IMMRMKW/KICAD/README.md

This repository contains some of the schematic part and housing libraries I created or found online in other repositories. I have put them online so that it will be easier for KICAD users to finish projects in which these parts happen to be integrated. Take care though, although most parts I really tried them out, there may still be some errors in them.

- [ ] some task
