IMMRMKW/KICAD/ugl-kicad-lib-master/README.md

# ugl-kicad-lib



Contains a KiCad library with many of the footprints required to create the Ultimate Hacking Keyboard.

[UHK github](https://github.com/UltimateHackingKeyboard)

[CrowdSupply](https://www.crowdsupply.com/ugl/ultimate-hacking-keyboard)

## Usage

**Open Eschema Editor**


**Preferences --> Component Libraries**



**Add a relative or absolute path to "User defined search path"**
