IMMRMKW/KICAD/random.png

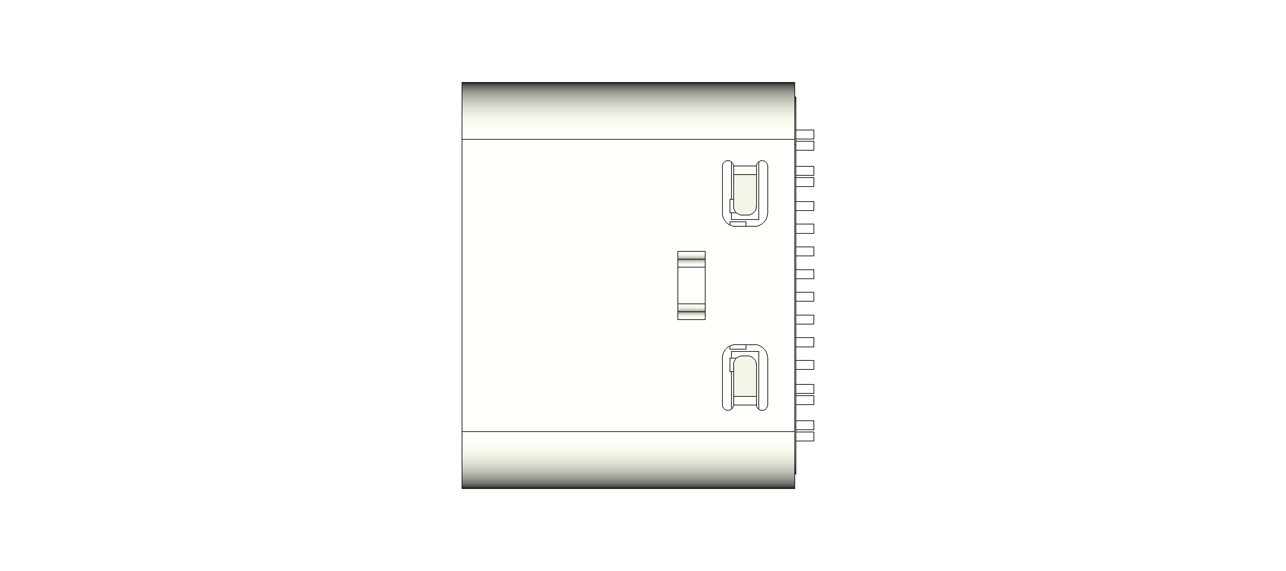
random.png
