IMMRMKW/KICAD/DC Power Jack 5.5mm x 2.1mm.STEP

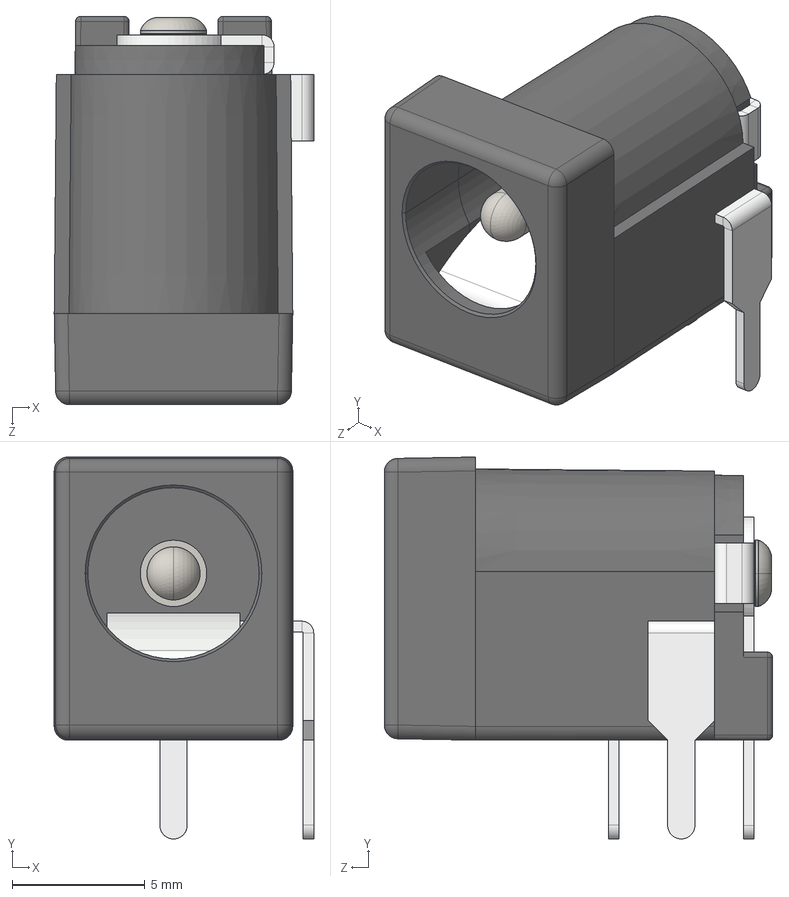
[picture p2: CAD file, 2023-07-05]
DC Power Jack 5.5mm x 2.1mm.STEP
9.77 x 14.4 x 14.6 mm
