IMMRMKW/KICAD/JST_SH/BMxxB-SRSR-TB/BM15B-SRSS-TB.STEP

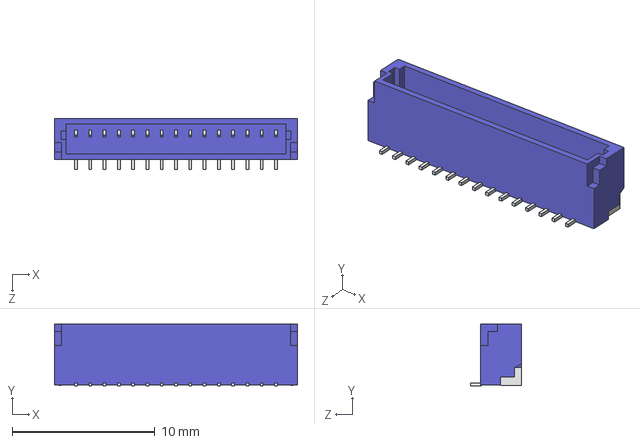
[picture p3: CAD file, 2023-07-05]
JST_SH/BMxxB-SRSR-TB/BM15B-SRSS-TB.STEP
17.0 x 4.32 x 3.60 mm
