IMMRMKW/KICAD/JST_SH/SHR-xxV-S-B/SHR-07V-S-B.STEP

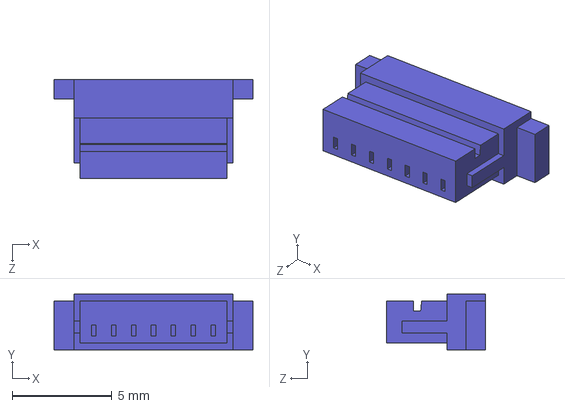
[picture p4: CAD file, 2023-07-05]
JST_SH/SHR-xxV-S-B/SHR-07V-S-B.STEP
10.0 x 2.80 x 5.00 mm
