IMMRMKW/KICAD/JST_SH/SHR-xxV-S/SHR-09V-S.STEP

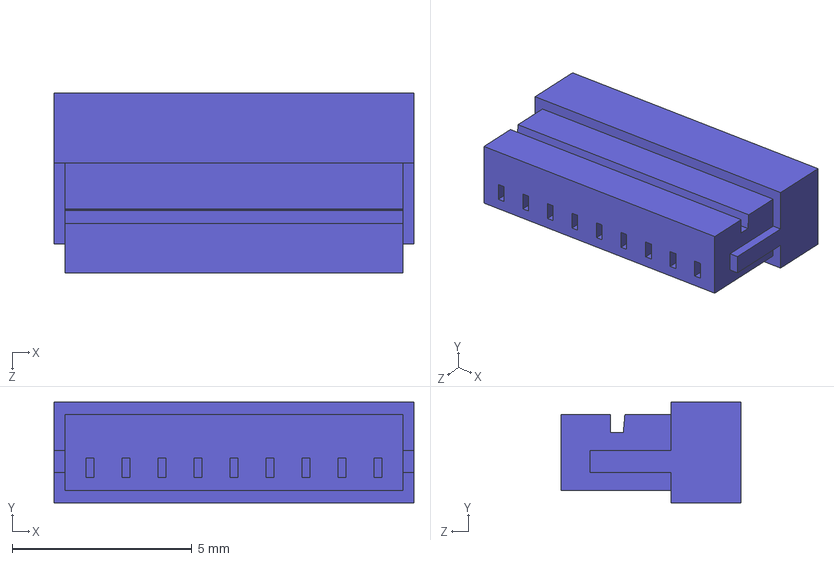
[picture p5: CAD file, 2023-07-05]
JST_SH/SHR-xxV-S/SHR-09V-S.STEP
10.0 x 2.80 x 5.00 mm
