IMMRMKW/KICAD/JST_SH/SMxxB-SRSS-TB/SM08B-SRSS-TB.STEP

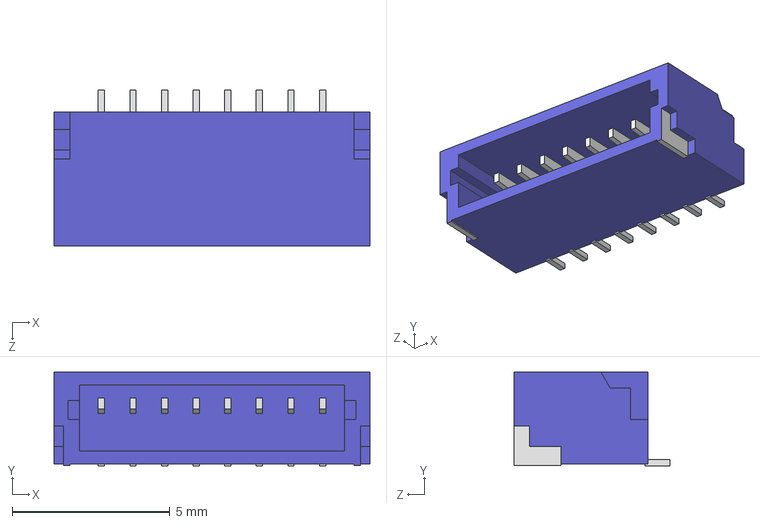
[picture p6: CAD file, 2023-07-05]
JST_SH/SMxxB-SRSS-TB/SM08B-SRSS-TB.STEP
10.0 x 2.96 x 4.95 mm
