IMMRMKW/KICAD/JST_SH/SSH-003T-P0.2-H/SSH-003T-P0.2-H.STEP

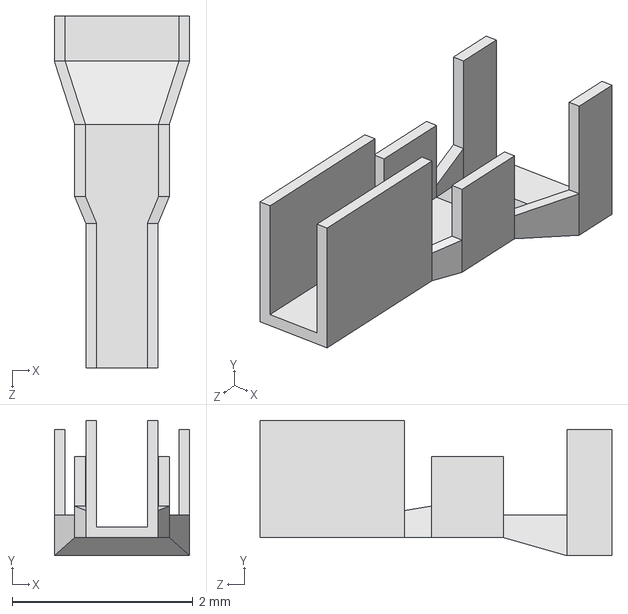
[picture p7: CAD file, 2023-07-05]
JST_SH/SSH-003T-P0.2-H/SSH-003T-P0.2-H.STEP
1.50 x 1.50 x 3.90 mm
