IMMRMKW/KICAD/HRO_TYPE-C-31-M-12.step

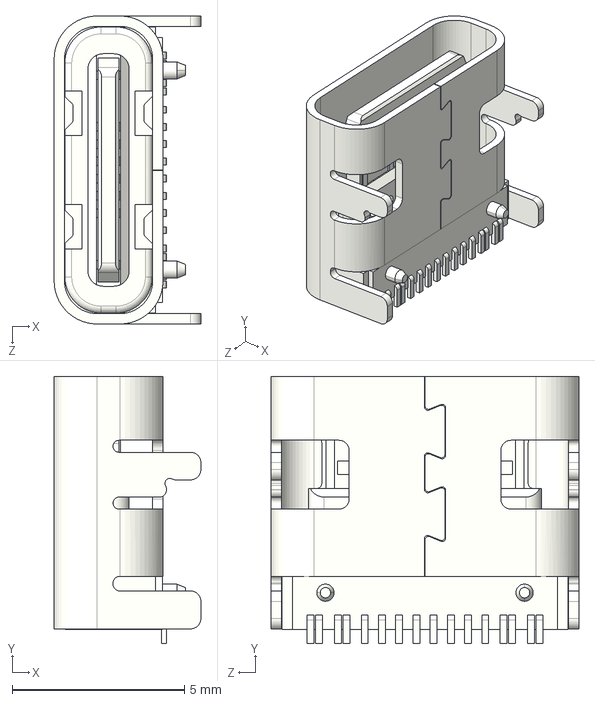
[picture p8: CAD file, 2023-07-05]
HRO_TYPE-C-31-M-12.step
4.26 x 7.75 x 8.94 mm
