IMMRMKW/KICAD/JST_SH/SHR-xxV-S-B/SHR-11V-S-B.STEP

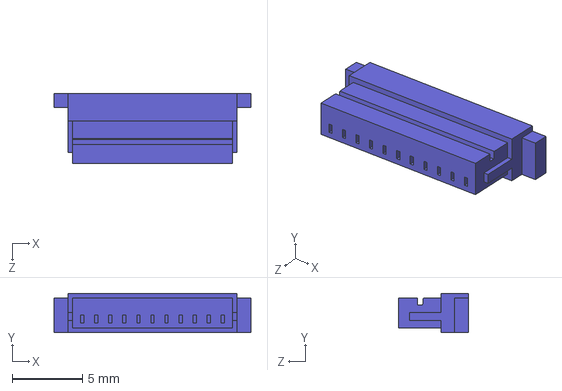
[picture p10: CAD file, 2023-07-05]
JST_SH/SHR-xxV-S-B/SHR-11V-S-B.STEP
14.0 x 2.80 x 5.00 mm
