IMMRMKW/KICAD/JST_SH/SHR-xxV-S/SHR-15V-S.STEP

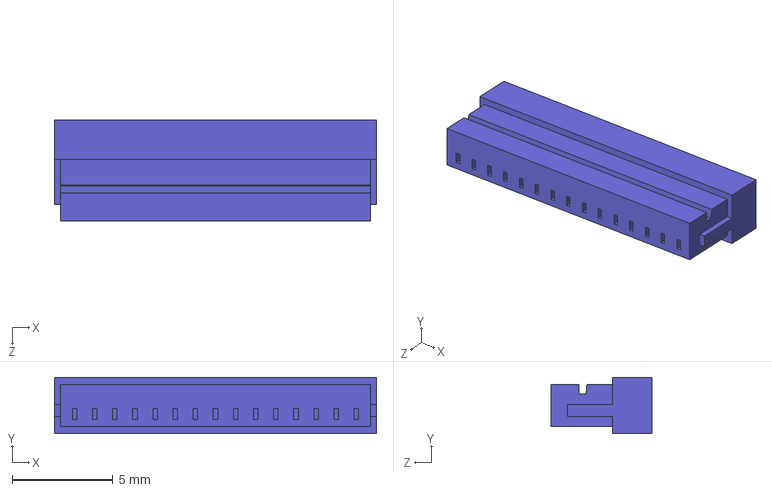
[picture p11: CAD file, 2023-07-05]
JST_SH/SHR-xxV-S/SHR-15V-S.STEP
16.0 x 2.80 x 5.00 mm
