IMMRMKW/KICAD/JST_SH/SMxxB-SRSS-TB/SM12B-SRSS-TB.STEP

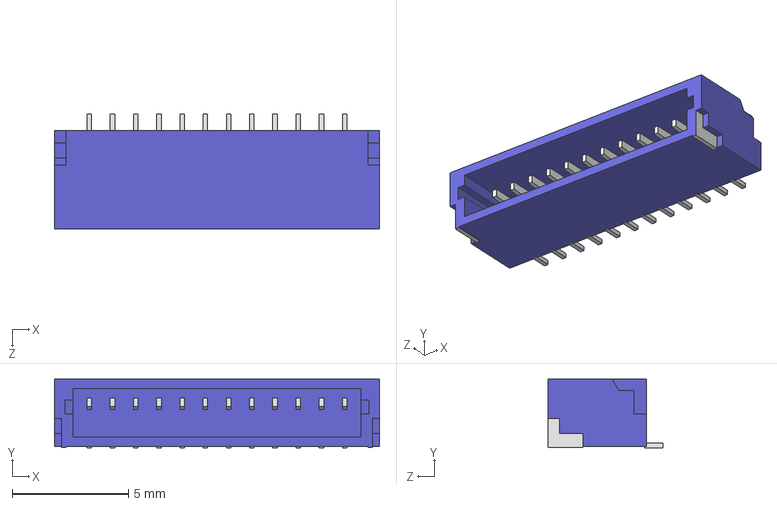
[picture p12: CAD file, 2023-07-05]
JST_SH/SMxxB-SRSS-TB/SM12B-SRSS-TB.STEP
14.0 x 2.96 x 4.95 mm
