IMMRMKW/KICAD/JST_SH/BMxxB-SRSR-TB/BM09B-SRSS-TB.STEP

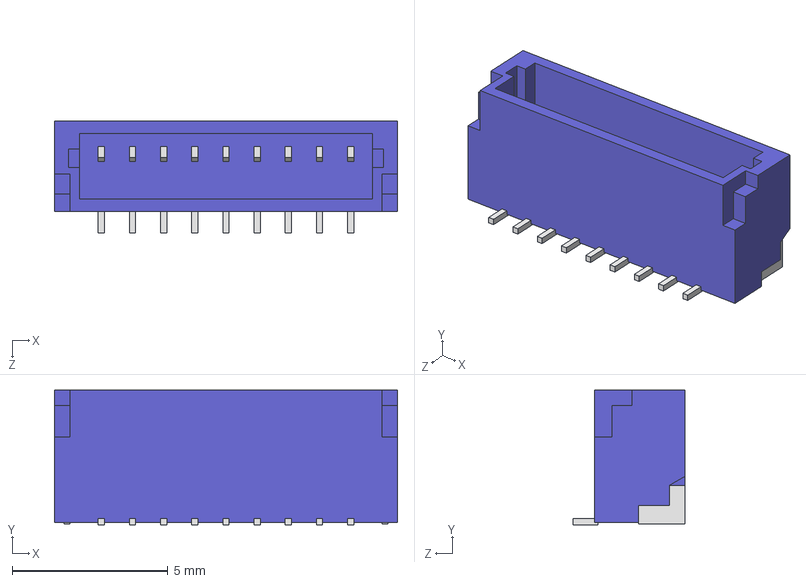
[picture p13: CAD file, 2023-07-05]
JST_SH/BMxxB-SRSR-TB/BM09B-SRSS-TB.STEP
11.0 x 4.32 x 3.60 mm
