IMMRMKW/KICAD/JST_SH/SHR-xxV-S-B/SHR-04V-S-B.STEP

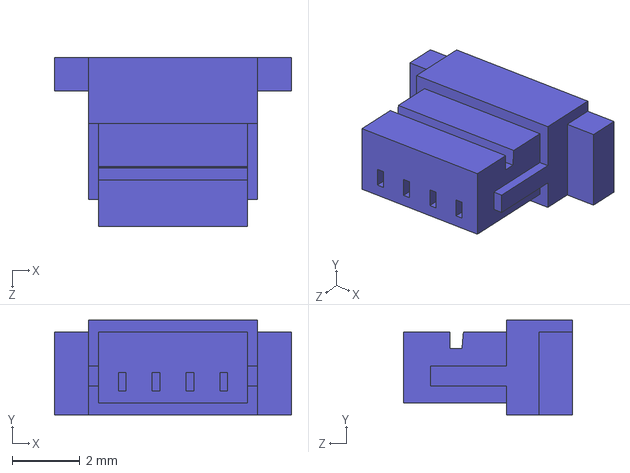
[picture p14: CAD file, 2023-07-05]
JST_SH/SHR-xxV-S-B/SHR-04V-S-B.STEP
7.00 x 2.80 x 5.00 mm
