IMMRMKW/KICAD/JST_SH/SHR-xxV-S/SHR-08V-S.STEP

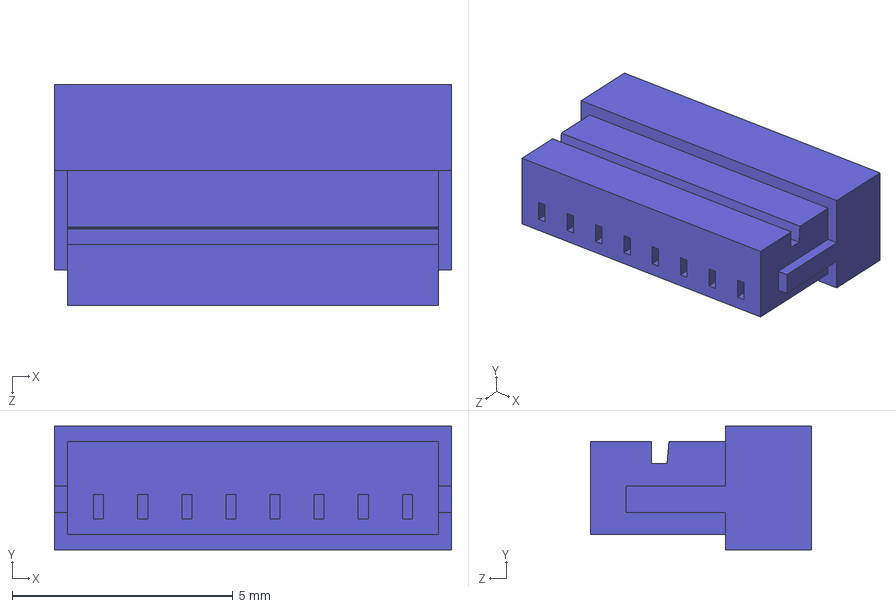
[picture p15: CAD file, 2023-07-05]
JST_SH/SHR-xxV-S/SHR-08V-S.STEP
9.00 x 2.80 x 5.00 mm
