IMMRMKW/KICAD/JST_SH/SMxxB-SRSS-TB/SM03B-SRSS-TB.STEP

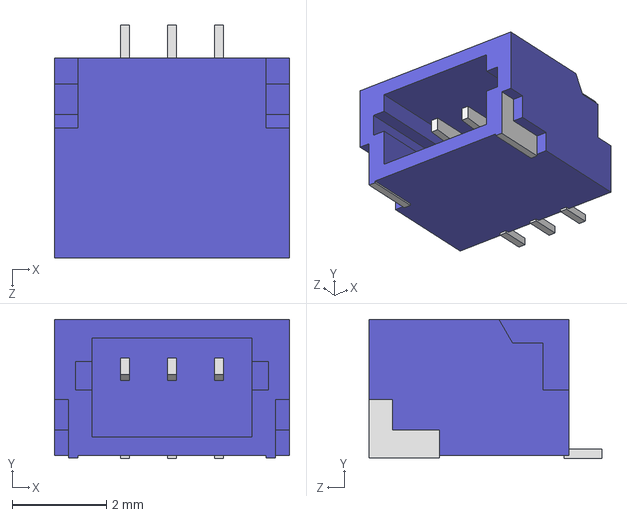
[picture p16: CAD file, 2023-07-05]
JST_SH/SMxxB-SRSS-TB/SM03B-SRSS-TB.STEP
5.00 x 2.96 x 4.95 mm
