IMMRMKW/KICAD/TSSOP-10.step

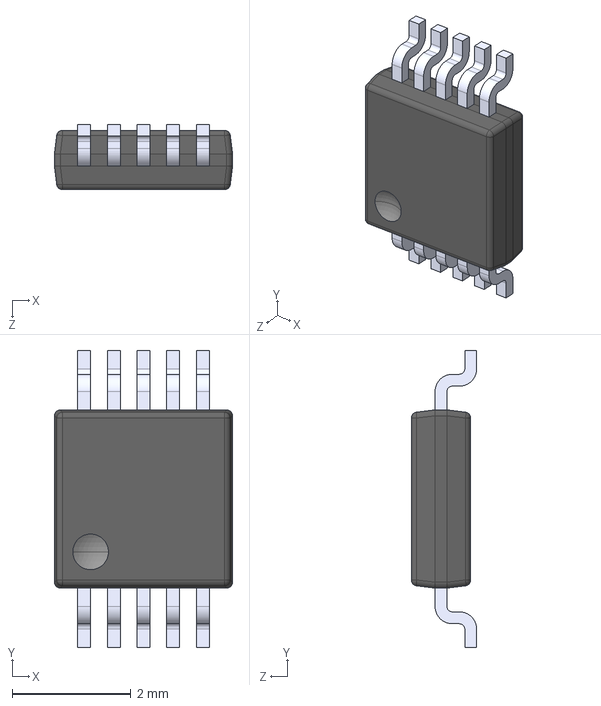
[picture p17: CAD file, 2023-07-05]
TSSOP-10.step
3.00 x 5.00 x 1.10 mm
