IMMRMKW/KICAD/JST_SH/SHR-xxV-S/SHR-07V-S.STEP

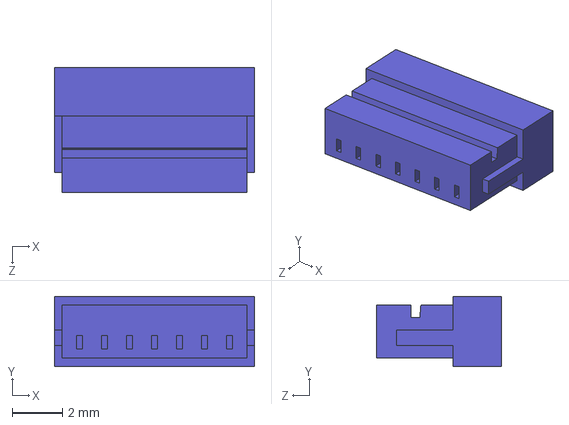
[picture p20: CAD file, 2023-07-05]
JST_SH/SHR-xxV-S/SHR-07V-S.STEP
8.00 x 2.80 x 5.00 mm
