IMMRMKW/KICAD/NFE61P series.STEP

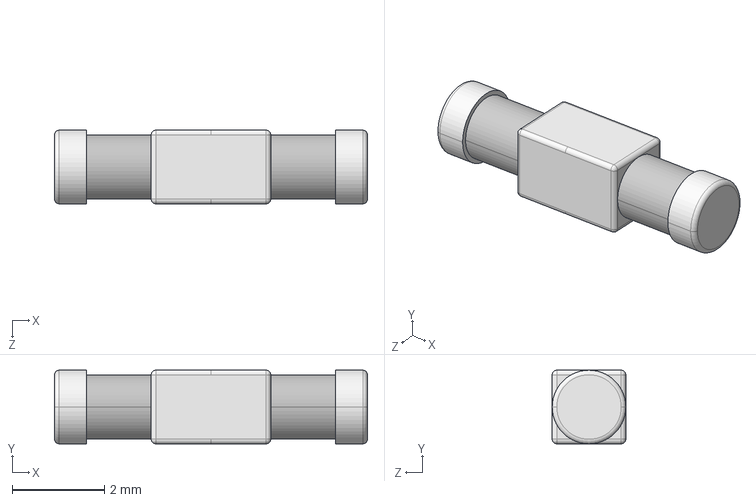
[picture p22: CAD file, 2023-07-05]
NFE61P series.STEP
6.80 x 1.60 x 1.60 mm
