IMMRMKW/KICAD/DC-005.step

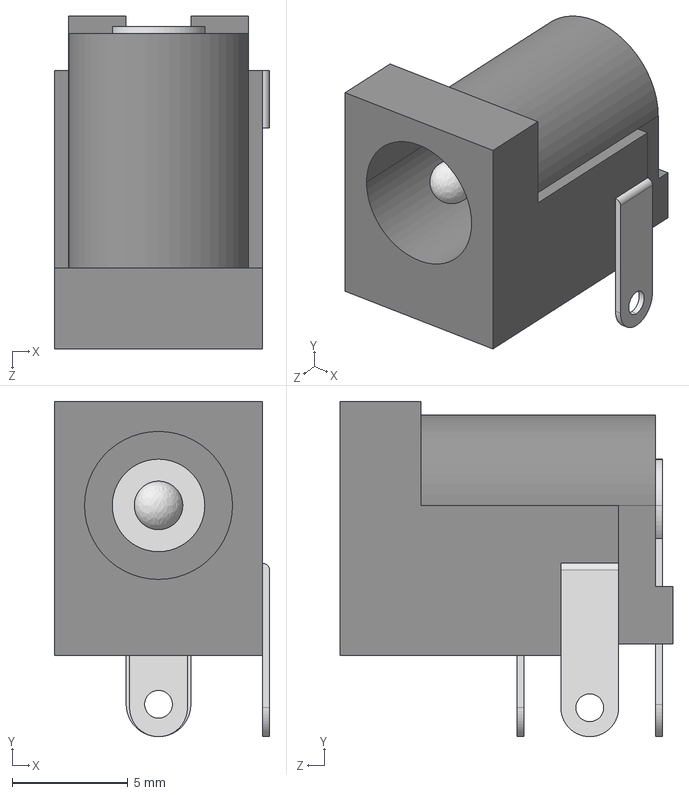
[picture p23: CAD file, 2023-07-05]
DC-005.step
9.30 x 14.5 x 14.4 mm
