IMMRMKW/KICAD/JST_SH/BMxxB-SRSR-TB/BM07B-SRSS-TB.STEP

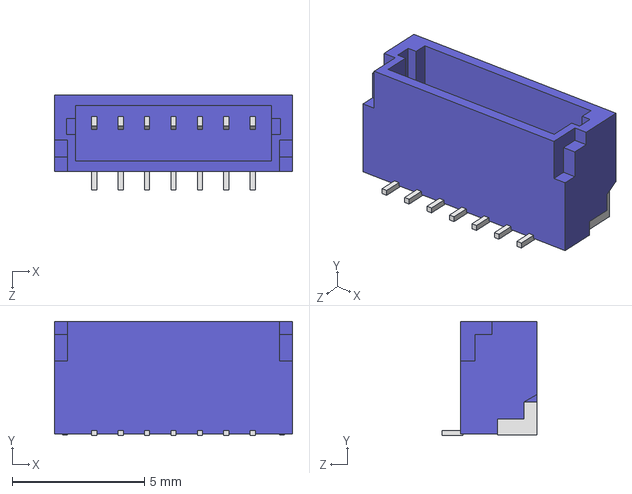
[picture p24: CAD file, 2023-07-05]
JST_SH/BMxxB-SRSR-TB/BM07B-SRSS-TB.STEP
9.00 x 4.32 x 3.60 mm
