IMMRMKW/KICAD/JST_SH/SHR-xxV-S-B/SHR-05V-S-B.STEP

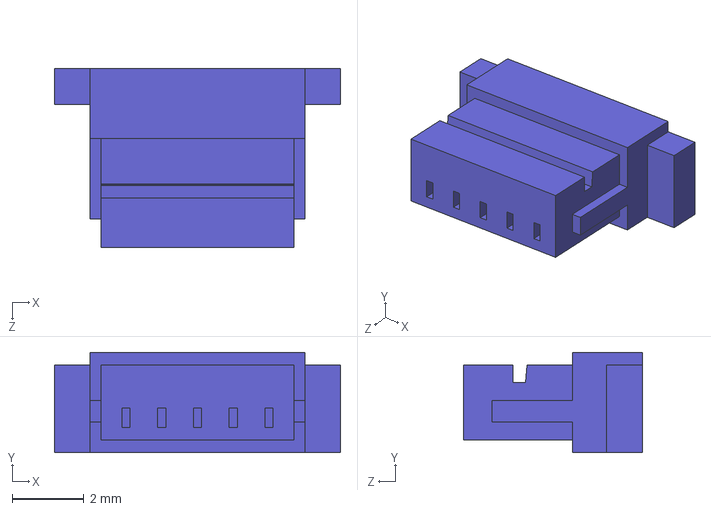
[picture p25: CAD file, 2023-07-05]
JST_SH/SHR-xxV-S-B/SHR-05V-S-B.STEP
8.00 x 2.80 x 5.00 mm
