IMMRMKW/KICAD/JST_SH/SHR-xxV-S/SHR-03V-S.STEP

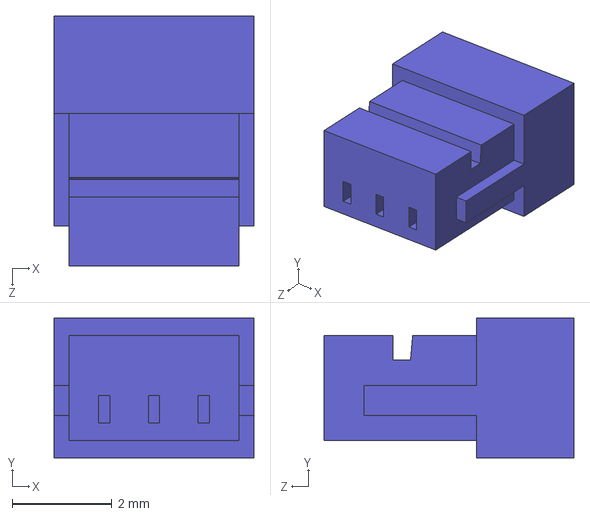
[picture p26: CAD file, 2023-07-05]
JST_SH/SHR-xxV-S/SHR-03V-S.STEP
4.00 x 2.80 x 5.00 mm
