IMMRMKW/KICAD/JST_SH/BMxxB-SRSR-TB/BM11B-SRSS-TB.STEP

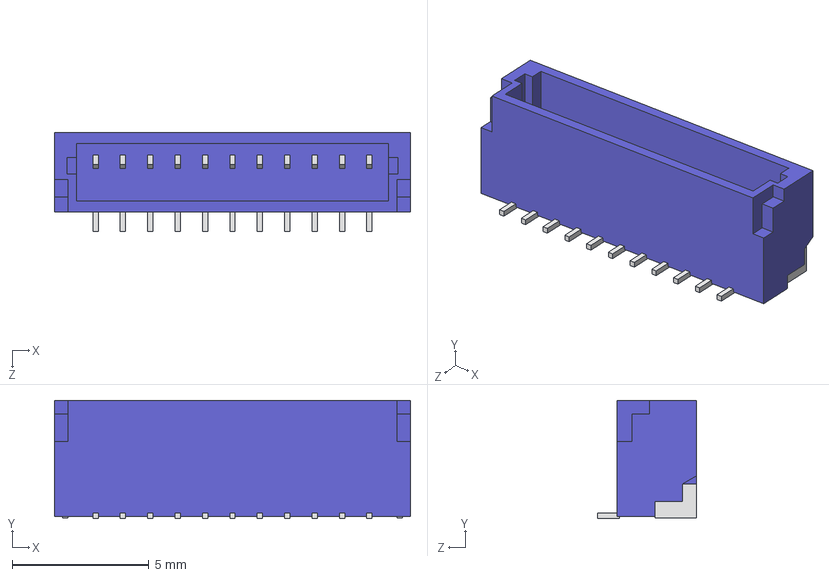
[picture p28: CAD file, 2023-07-05]
JST_SH/BMxxB-SRSR-TB/BM11B-SRSS-TB.STEP
13.0 x 4.32 x 3.60 mm
