IMMRMKW/KICAD/JST_SH/SHR-xxV-S/SHR-05V-S.STEP

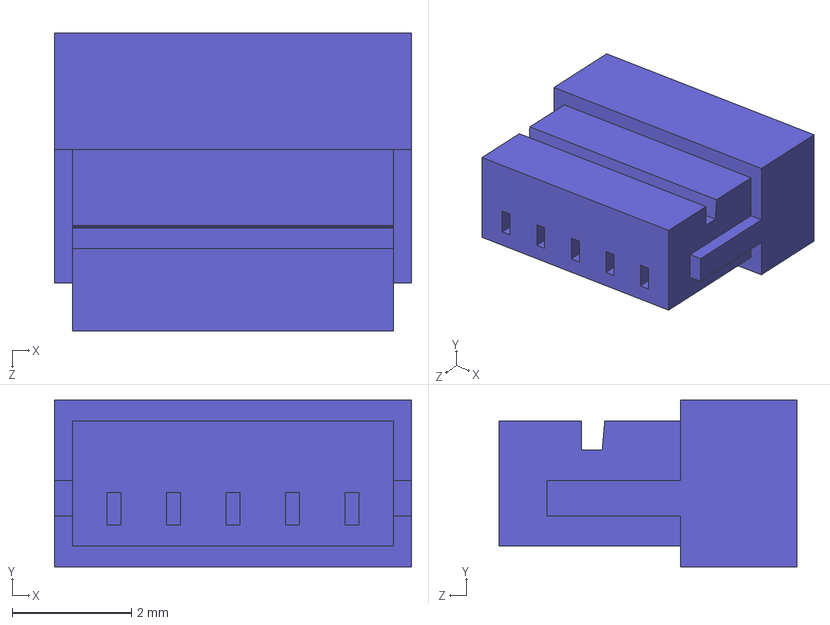
[picture p30: CAD file, 2023-07-05]
JST_SH/SHR-xxV-S/SHR-05V-S.STEP
6.00 x 2.80 x 5.00 mm
