IMMRMKW/KICAD/JST_SH/SMxxB-SRSS-TB/SM04B-SRSS-TB.STEP

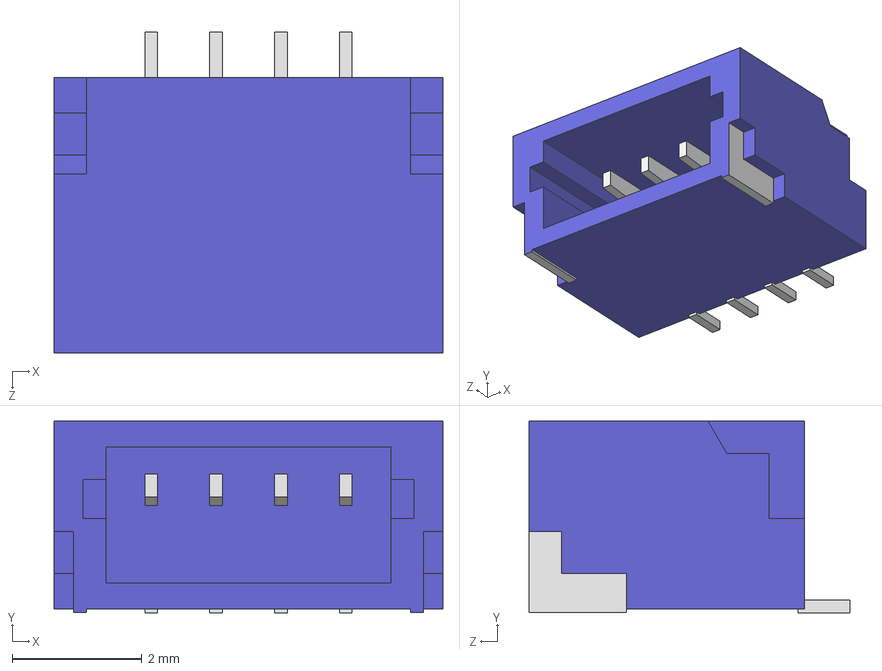
[picture p31: CAD file, 2023-07-05]
JST_SH/SMxxB-SRSS-TB/SM04B-SRSS-TB.STEP
6.00 x 2.96 x 4.95 mm
