IMMRMKW/KICAD/Yuandi TS-1092S-B3D2-G.STEP

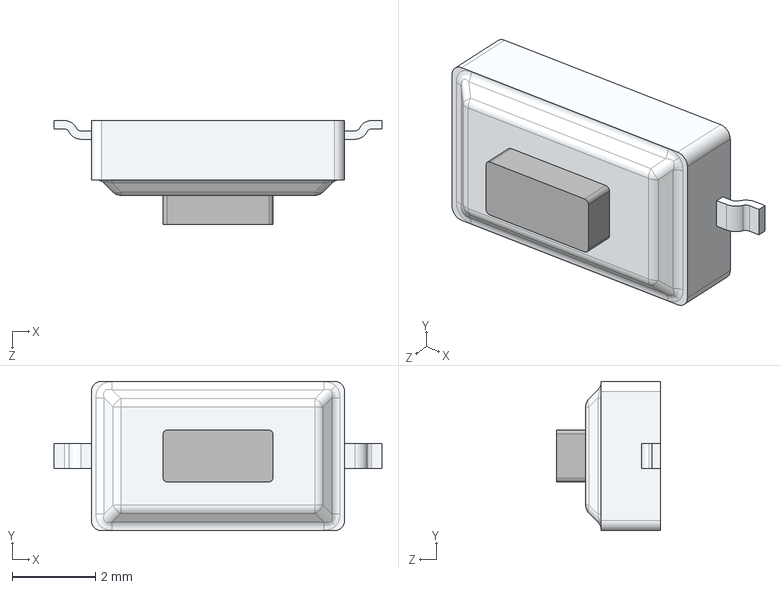
[picture p32: CAD file, 2023-07-05]
Yuandi TS-1092S-B3D2-G.STEP
7.90 x 3.60 x 2.50 mm
