IMMRMKW/KICAD/JST_SH/BMxxB-SRSR-TB/BM04B-SRSS-TB.STEP

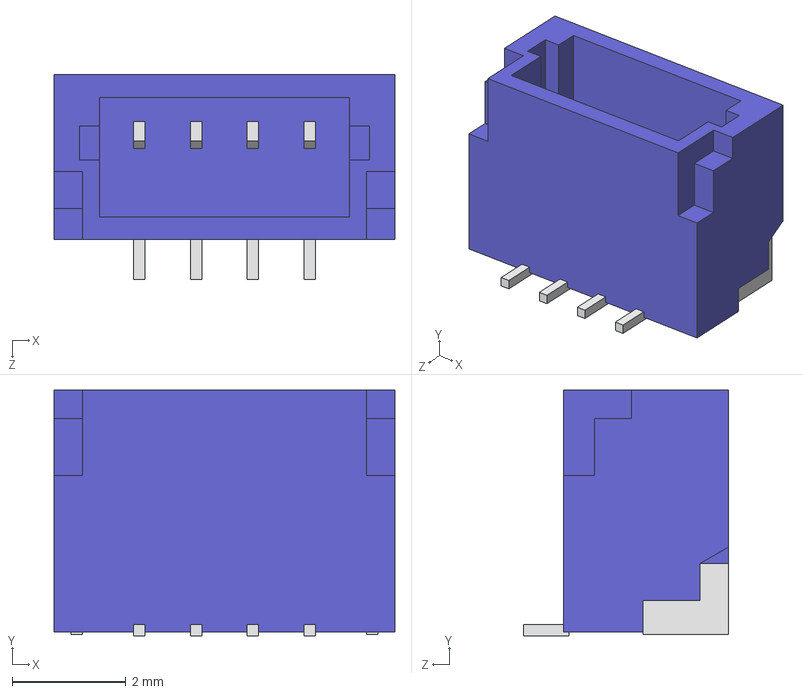
[picture p33: CAD file, 2023-07-05]
JST_SH/BMxxB-SRSR-TB/BM04B-SRSS-TB.STEP
6.00 x 4.32 x 3.60 mm
