IMMRMKW/KICAD/JST_SH/SHR-xxV-S/SHR-02V-S.STEP

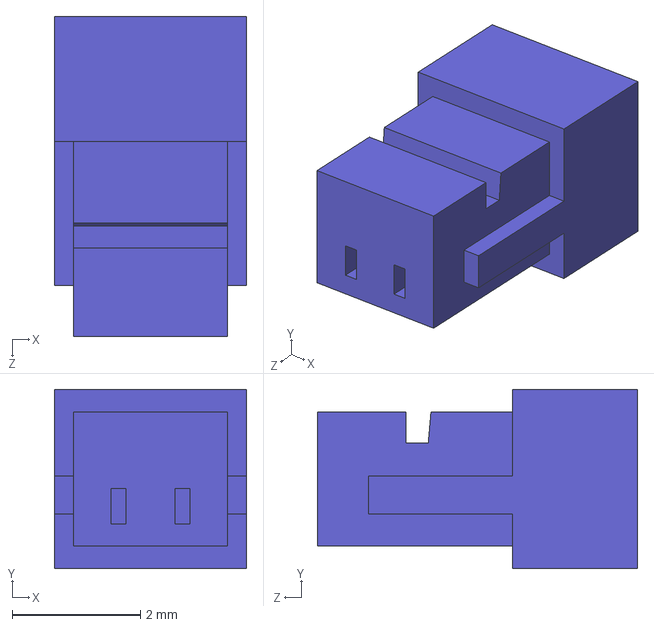
[picture p35: CAD file, 2023-07-05]
JST_SH/SHR-xxV-S/SHR-02V-S.STEP
3.00 x 2.80 x 5.00 mm
