IMMRMKW/KICAD/JST_SH/SMxxB-SRSS-TB/SM13B-SRSS-TB.STEP

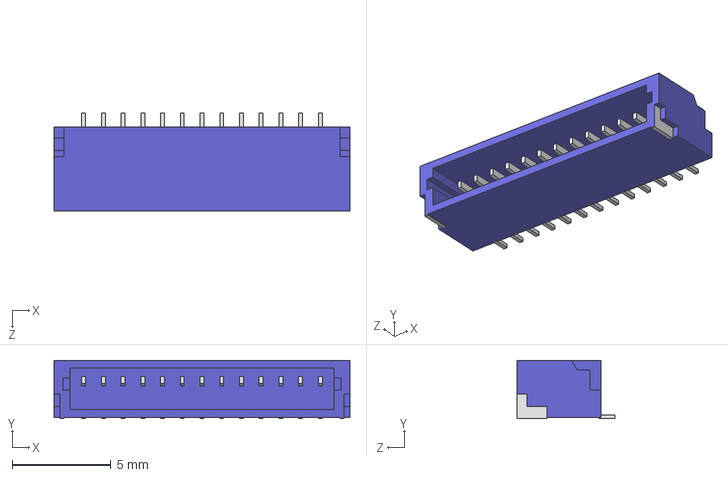
[picture p36: CAD file, 2023-07-05]
JST_SH/SMxxB-SRSS-TB/SM13B-SRSS-TB.STEP
15.0 x 2.96 x 4.95 mm
