IMMRMKW/KICAD/Fuse 2920.step

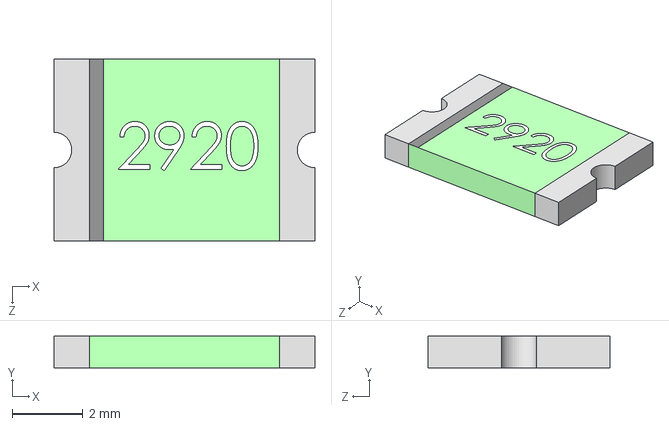
[picture p37: CAD file, 2023-07-05]
Fuse 2920.step
7.36 x 0.901 x 5.12 mm
