IMMRMKW/KICAD/JST_SH/BMxxB-SRSR-TB/BM14B-SRSS-TB.STEP

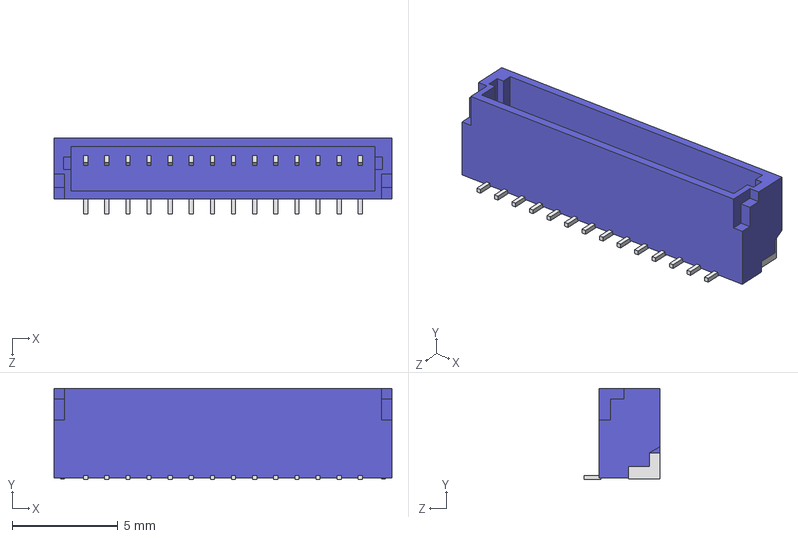
[picture p38: CAD file, 2023-07-05]
JST_SH/BMxxB-SRSR-TB/BM14B-SRSS-TB.STEP
16.0 x 4.32 x 3.60 mm
