IMMRMKW/KICAD/JST_SH/SHR-xxV-S/SHR-12V-S.STEP

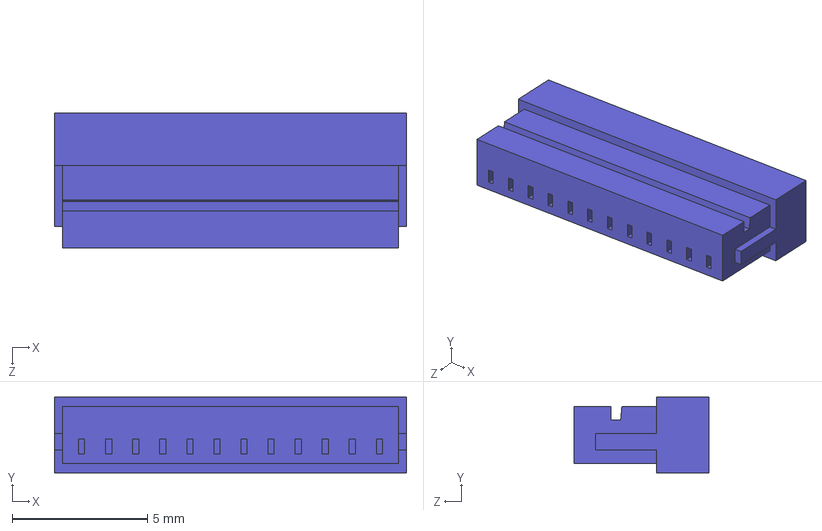
[picture p40: CAD file, 2023-07-05]
JST_SH/SHR-xxV-S/SHR-12V-S.STEP
13.0 x 2.80 x 5.00 mm
