IMMRMKW/KICAD/JST_SH/SMxxB-SRSS-TB/SM10B-SRSS-TB.STEP

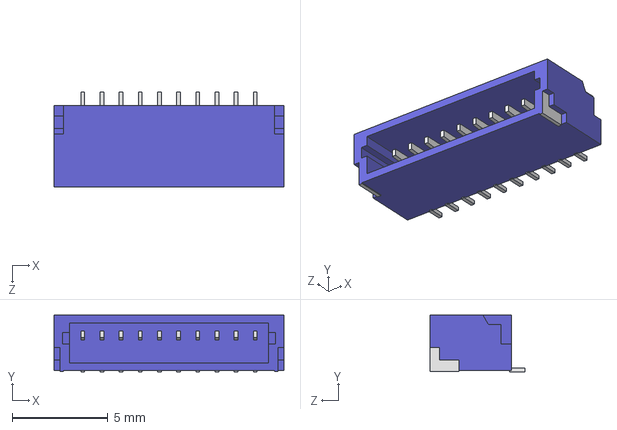
[picture p41: CAD file, 2023-07-05]
JST_SH/SMxxB-SRSS-TB/SM10B-SRSS-TB.STEP
12.0 x 2.96 x 4.95 mm
