IMMRMKW/KICAD/JST_SH/BMxxB-SRSR-TB/BM10B-SRSS-TB.STEP

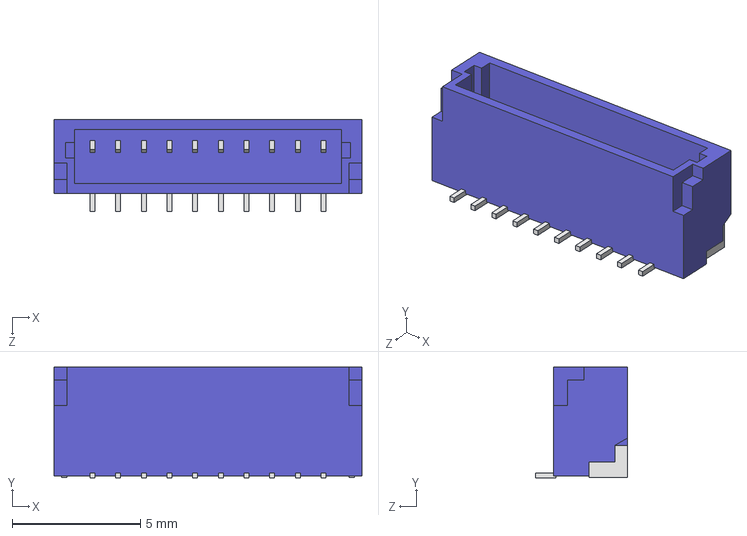
[picture p42: CAD file, 2023-07-05]
JST_SH/BMxxB-SRSR-TB/BM10B-SRSS-TB.STEP
12.0 x 4.32 x 3.60 mm
