IMMRMKW/KICAD/JST_SH/SHR-xxV-S-B/SHR-02V-S-B.STEP

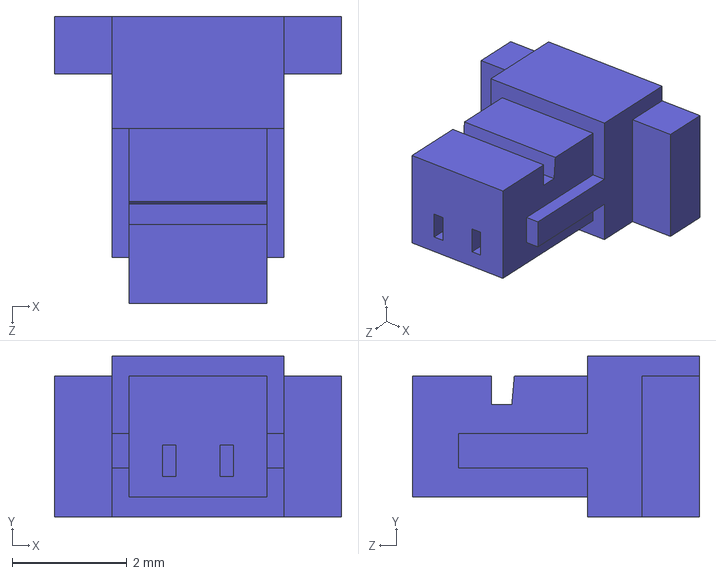
[picture p43: CAD file, 2023-07-05]
JST_SH/SHR-xxV-S-B/SHR-02V-S-B.STEP
5.00 x 2.80 x 5.00 mm
