IMMRMKW/KICAD/JST_SH/SHR-xxV-S/SHR-06V-S.STEP

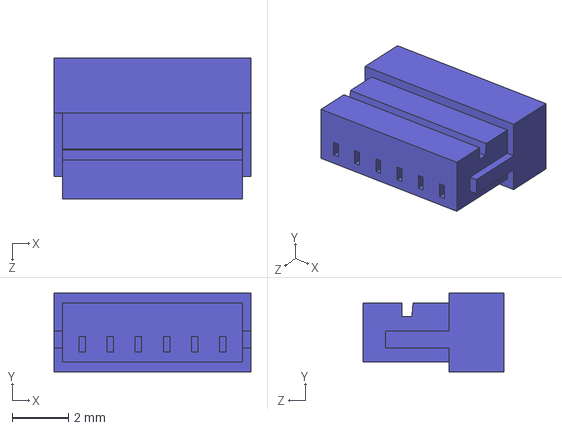
[picture p44: CAD file, 2023-07-05]
JST_SH/SHR-xxV-S/SHR-06V-S.STEP
7.00 x 2.80 x 5.00 mm
