IMMRMKW/KICAD/SMMS0850.STEP

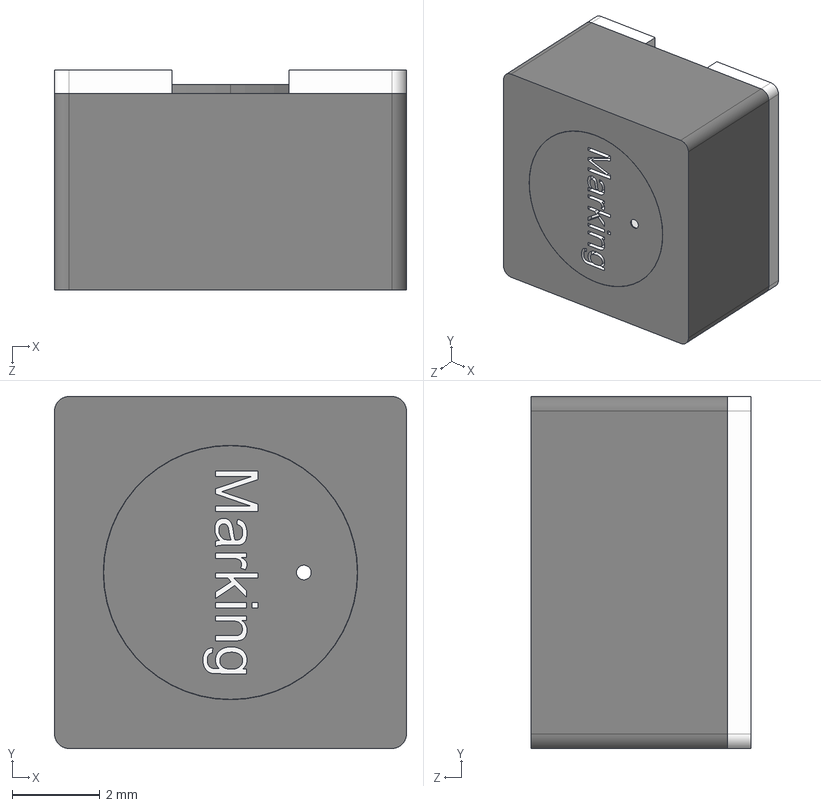
[picture p46: CAD file, 2023-07-05]
SMMS0850.STEP
8.02 x 8.02 x 5.00 mm
