IMMRMKW/KICAD/031-5539.STEP

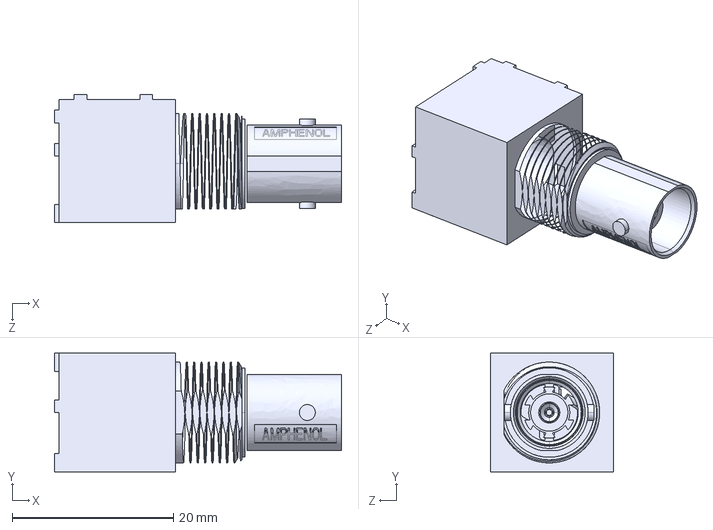
[picture p47: CAD file, 2021-09-19]
031-5539.STEP
35.6 x 14.7 x 15.9 mm
