IMMRMKW/KICAD/JST_SH/SHR-xxV-S/SHR-11V-S.STEP

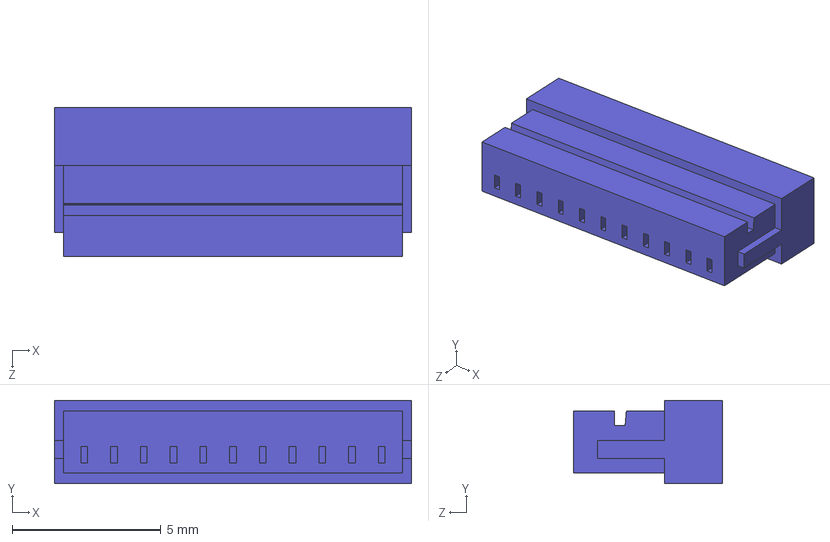
[picture p50: CAD file, 2023-07-05]
JST_SH/SHR-xxV-S/SHR-11V-S.STEP
12.0 x 2.80 x 5.00 mm
