IMMRMKW/KICAD/JST_SH/SMxxB-SRSS-TB/SM09B-SRSS-TB.STEP

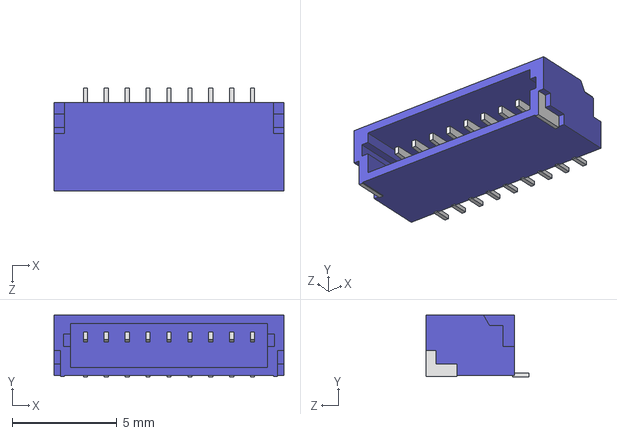
[picture p51: CAD file, 2023-07-05]
JST_SH/SMxxB-SRSS-TB/SM09B-SRSS-TB.STEP
11.0 x 2.96 x 4.95 mm
