IMMRMKW/KICAD/JST_SH/SHR-xxV-S/SHR-10V-S.STEP

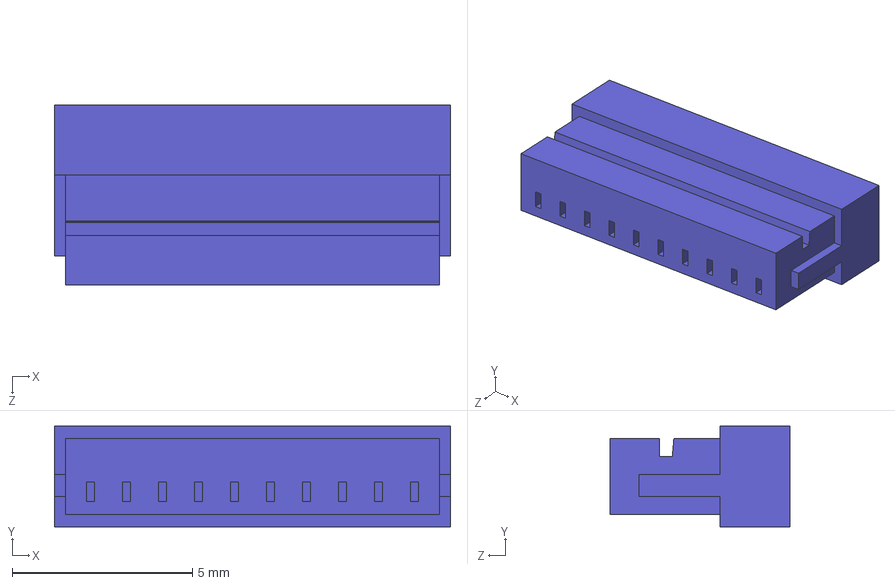
[picture p54: CAD file, 2023-07-05]
JST_SH/SHR-xxV-S/SHR-10V-S.STEP
11.0 x 2.80 x 5.00 mm
