IMMRMKW/KICAD/JST_SH/SMxxB-SRSS-TB/SM07B-SRSS-TB.STEP

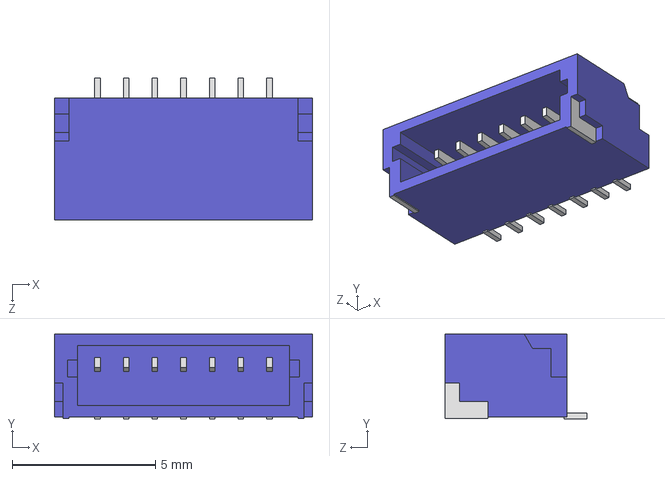
[picture p55: CAD file, 2023-07-05]
JST_SH/SMxxB-SRSS-TB/SM07B-SRSS-TB.STEP
9.00 x 2.96 x 4.95 mm
