IMMRMKW/KICAD/Multicomp-ABI-050-RC.STEP

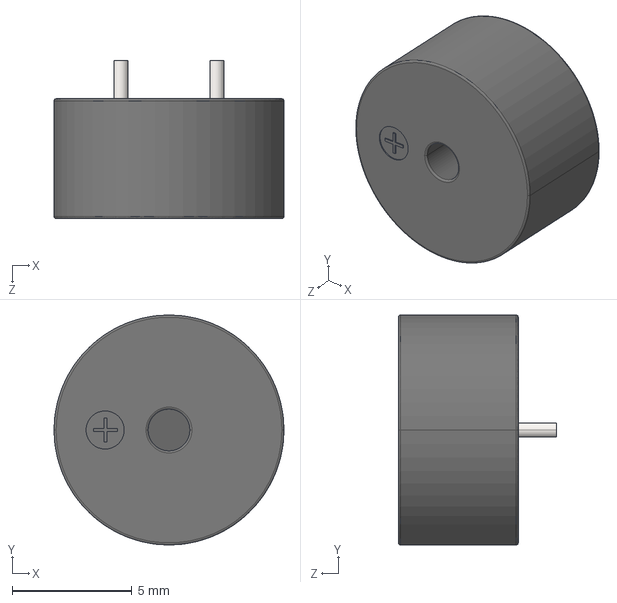
[picture p56: CAD file, 2021-09-19]
Multicomp-ABI-050-RC.STEP
9.59 x 9.59 x 6.60 mm
