IMMRMKW/KICAD/JST_SH/BMxxB-SRSR-TB/BM13B-SRSS-TB.STEP

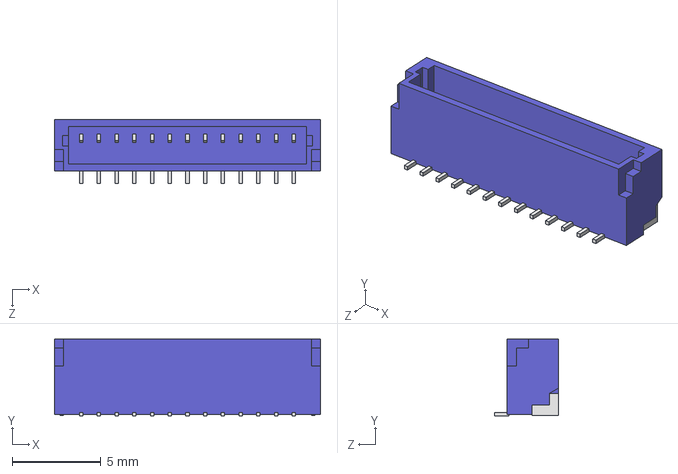
[picture p57: CAD file, 2023-07-05]
JST_SH/BMxxB-SRSR-TB/BM13B-SRSS-TB.STEP
15.0 x 4.32 x 3.60 mm
