IMMRMKW/KICAD/JST_SH/SHR-xxV-S-B/SHR-20V-S-B.STEP

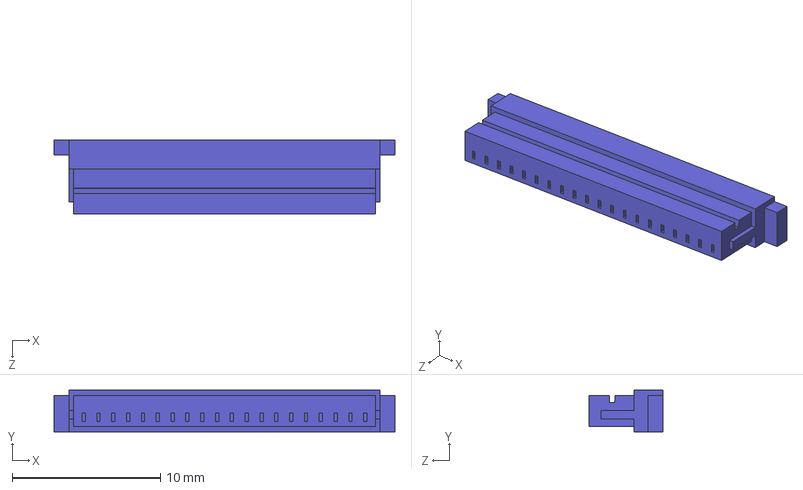
[picture p58: CAD file, 2023-07-05]
JST_SH/SHR-xxV-S-B/SHR-20V-S-B.STEP
23.0 x 2.80 x 5.00 mm
