IMMRMKW/KICAD/JST_SH/SHR-xxV-S/SHR-04V-S.STEP

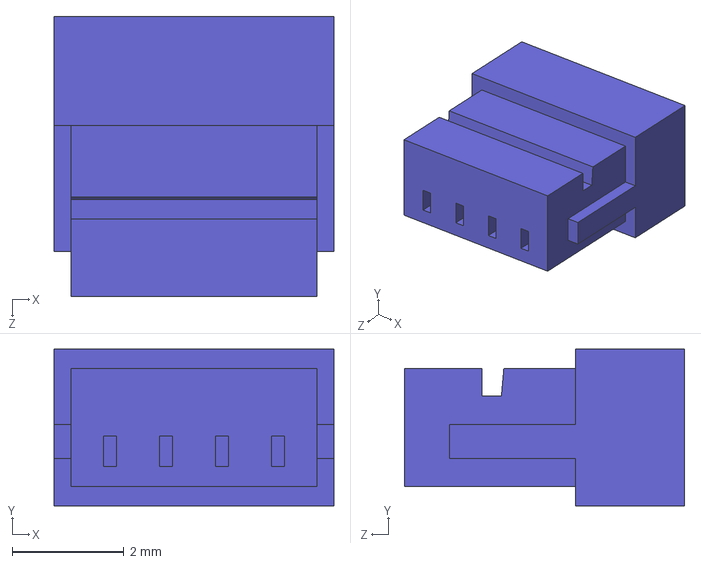
[picture p59: CAD file, 2023-07-05]
JST_SH/SHR-xxV-S/SHR-04V-S.STEP
5.00 x 2.80 x 5.00 mm
