IMMRMKW/KICAD/PCL712A.step

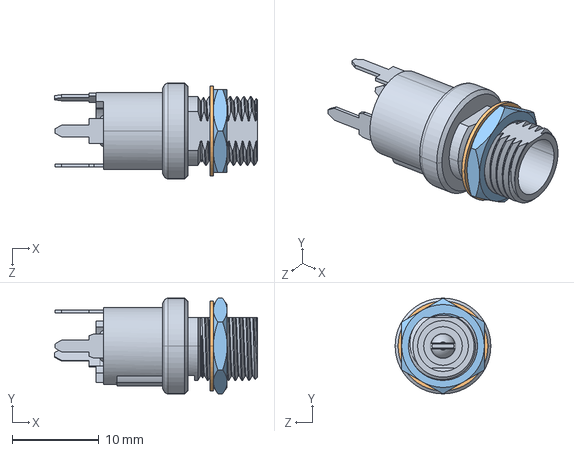
[picture p61: CAD file, 2021-09-19]
PCL712A.step
23.4 x 11.0 x 11.0 mm
