IMMRMKW/KICAD/JST_SH/BMxxB-SRSR-TB/BM08B-SRSS-TB.STEP

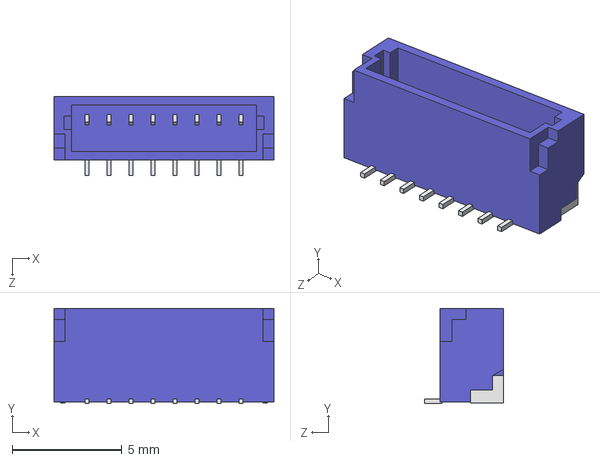
[picture p62: CAD file, 2023-07-05]
JST_SH/BMxxB-SRSR-TB/BM08B-SRSS-TB.STEP
10.0 x 4.32 x 3.60 mm
