IMMRMKW/KICAD/JST_SH/SHR-xxV-S-B/SHR-06V-S-B.STEP

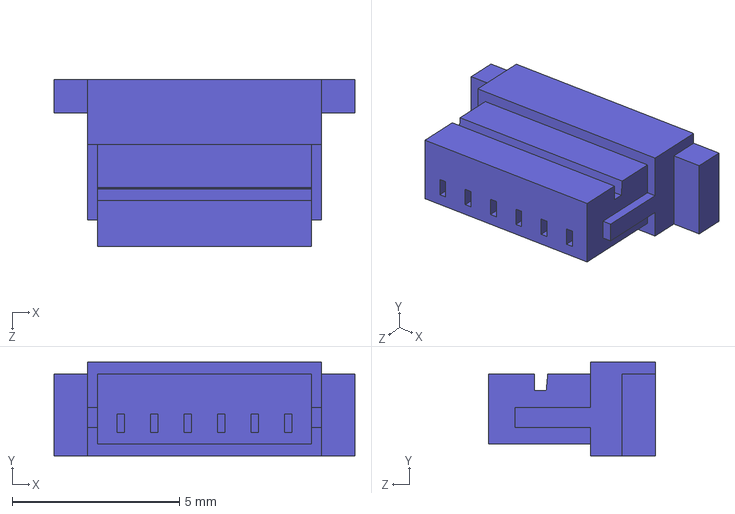
[picture p63: CAD file, 2023-07-05]
JST_SH/SHR-xxV-S-B/SHR-06V-S-B.STEP
9.00 x 2.80 x 5.00 mm
