IMMRMKW/KICAD/JST_SH/SHR-xxV-S/SHR-14V-S.STEP

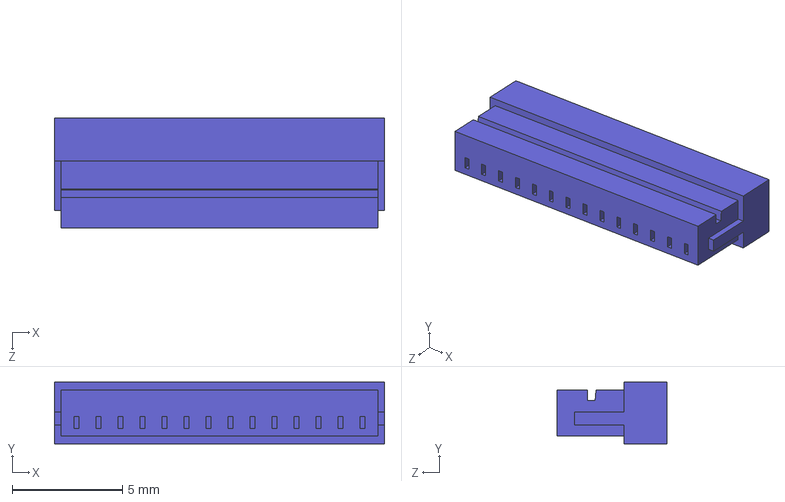
[picture p64: CAD file, 2023-07-05]
JST_SH/SHR-xxV-S/SHR-14V-S.STEP
15.0 x 2.80 x 5.00 mm
