IMMRMKW/KICAD/JST_SH/SMxxB-SRSS-TB/SM02B-SRSS-TB.STEP

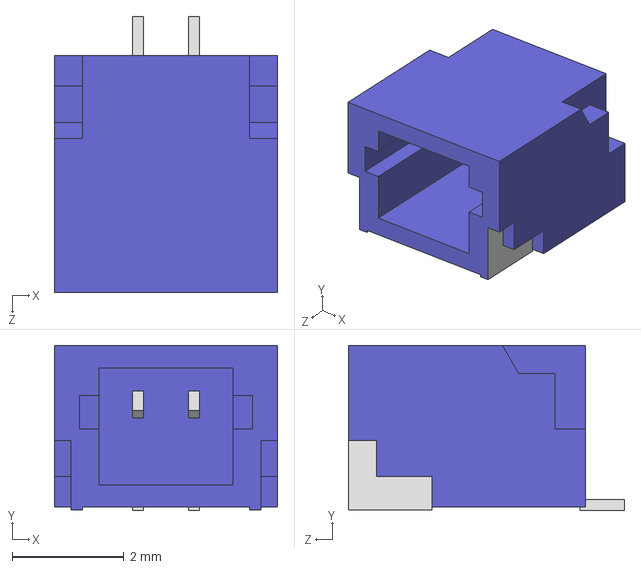
[picture p65: CAD file, 2023-07-05]
JST_SH/SMxxB-SRSS-TB/SM02B-SRSS-TB.STEP
4.00 x 2.96 x 4.95 mm
