IMMRMKW/KICAD/nc3fbv2-1.stp

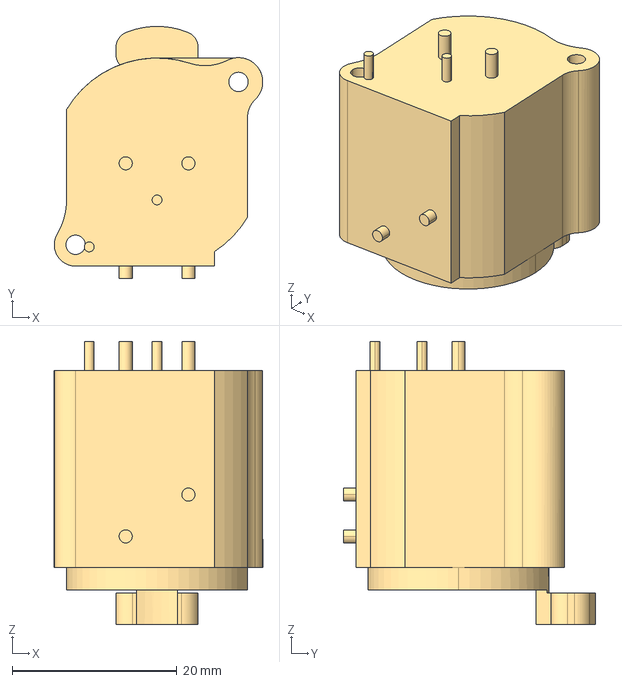
[picture p66: CAD file, 2021-09-19]
nc3fbv2-1.stp
25.3 x 30.6 x 34.4 mm
