IMMRMKW/KICAD/JST_SH/BMxxB-SRSR-TB/BM02B-SRSS-TB.STEP

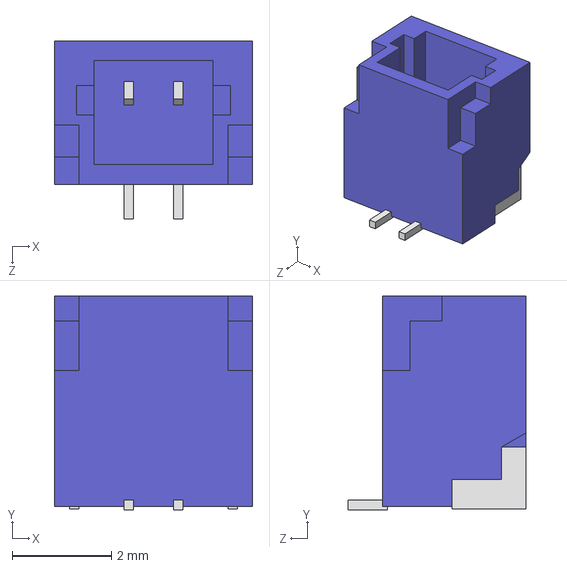
[picture p67: CAD file, 2023-07-05]
JST_SH/BMxxB-SRSR-TB/BM02B-SRSS-TB.STEP
4.00 x 4.32 x 3.60 mm
