IMMRMKW/KICAD/JST_SH/SHR-xxV-S-B/SHR-09V-S-B.STEP

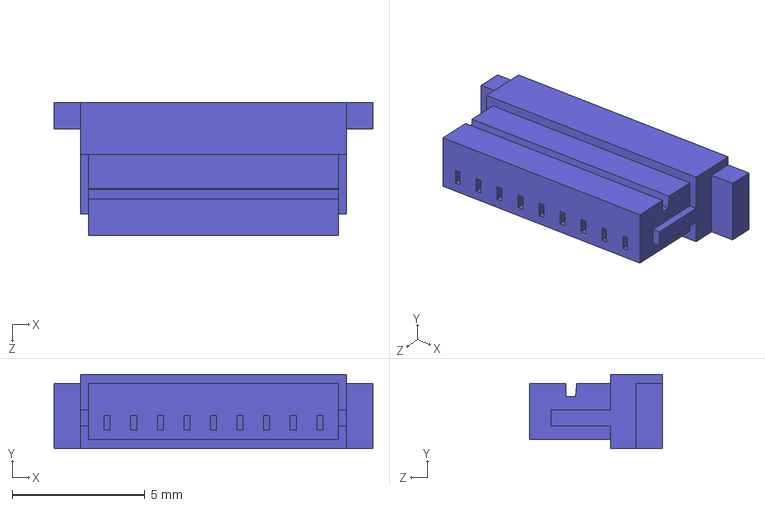
[picture p68: CAD file, 2023-07-05]
JST_SH/SHR-xxV-S-B/SHR-09V-S-B.STEP
12.0 x 2.80 x 5.00 mm
