IMMRMKW/KICAD/JST_SH/SHR-xxV-S/SHR-13V-S.STEP

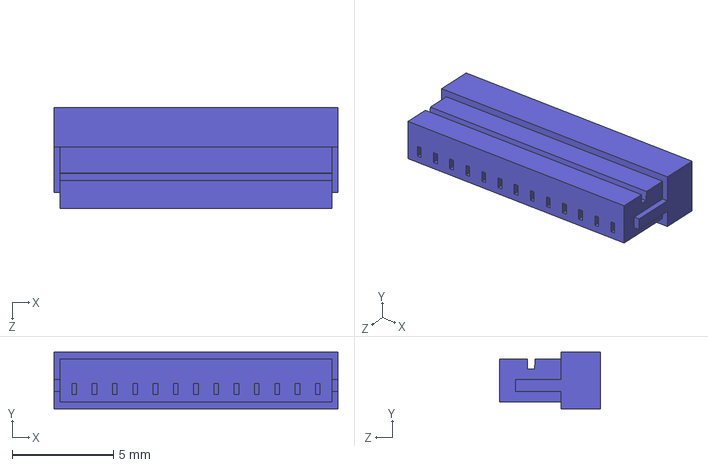
[picture p69: CAD file, 2023-07-05]
JST_SH/SHR-xxV-S/SHR-13V-S.STEP
14.0 x 2.80 x 5.00 mm
