IMMRMKW/KICAD/JST_SH/SMxxB-SRSS-TB/SM06B-SRSS-TB.STEP

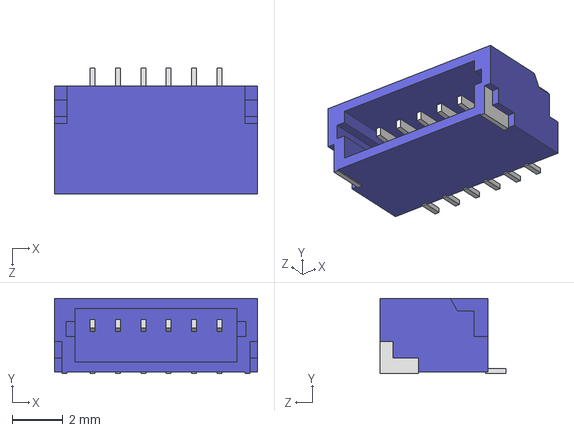
[picture p70: CAD file, 2023-07-05]
JST_SH/SMxxB-SRSS-TB/SM06B-SRSS-TB.STEP
8.00 x 2.96 x 4.95 mm
