IMMRMKW/KICAD/Radial can size G.STEP

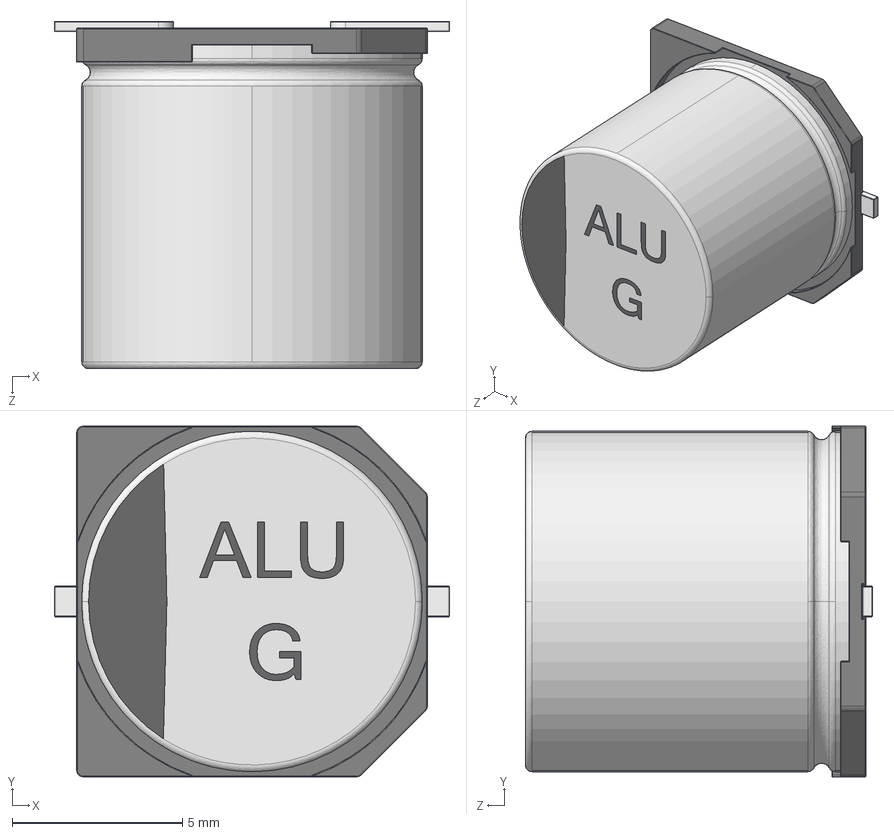
[picture p71: CAD file, 2021-05-26]
Radial can size G.STEP
11.6 x 10.3 x 10.2 mm
Pins_1
Fuss_1
K_X_F6rper_1
Beschriftung_1
