IMMRMKW/KICAD/JST_SH/SHR-xxV-S-B/SHR-12V-S-B.STEP

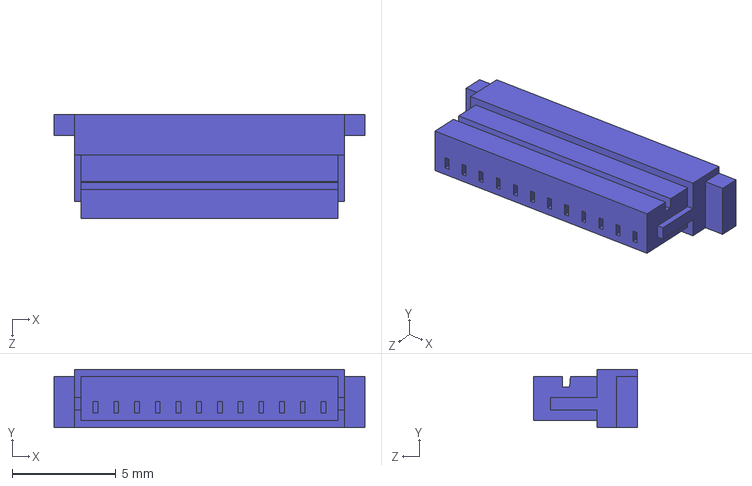
[picture p72: CAD file, 2023-07-05]
JST_SH/SHR-xxV-S-B/SHR-12V-S-B.STEP
15.0 x 2.80 x 5.00 mm
