IMMRMKW/KICAD/2061-602_998-404.stp

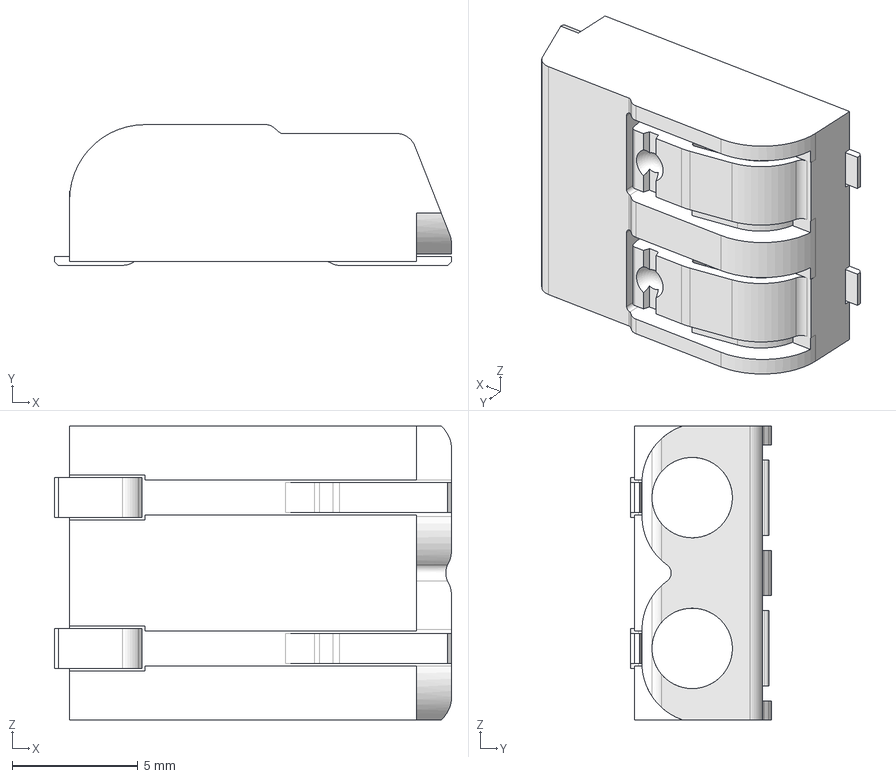
[picture p74: CAD file, 2021-05-26]
2061-602_998-404.stp
15.8 x 5.60 x 11.7 mm
