IMMRMKW/KICAD/Automotive_fuse.STEP

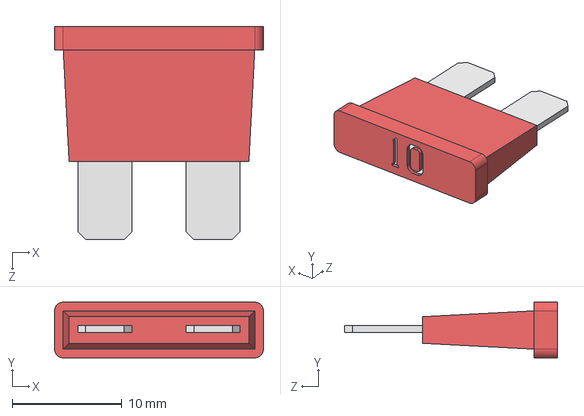
[picture p75: CAD file, 2021-05-26]
Automotive_fuse.STEP
19.1 x 5.08 x 19.4 mm
