IMMRMKW/KICAD/Pin Header Socket 1x5 Pitch 2_54mm.STEP

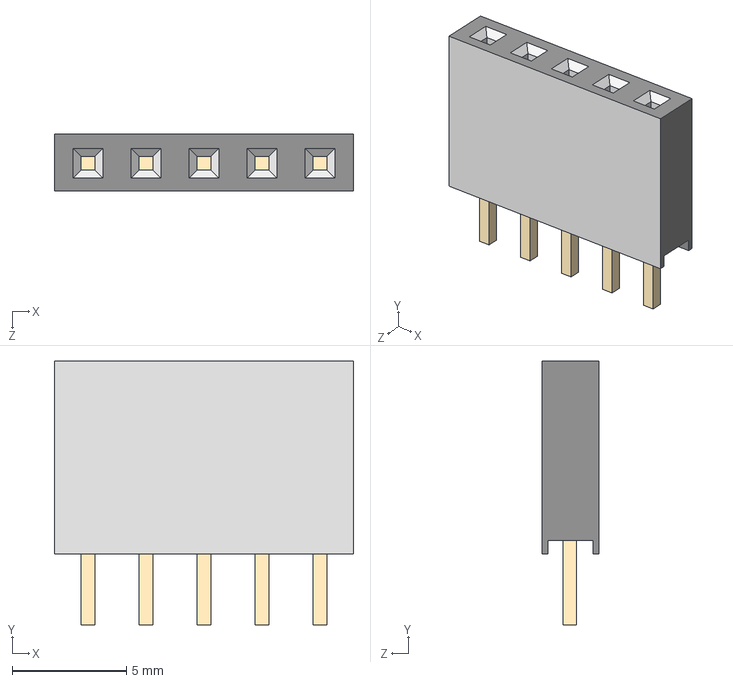
[picture p76: CAD file, 2021-05-26]
Pin Header Socket 1x5 Pitch 2_54mm.STEP
13.1 x 11.5 x 2.50 mm
