IMMRMKW/KICAD/LF-102071.STEP

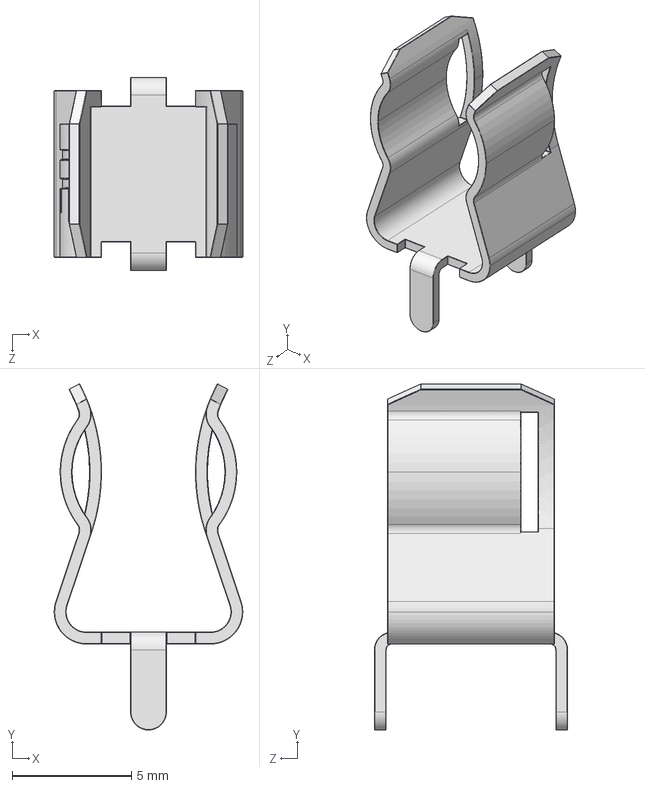
[picture p77: CAD file, 2021-05-26]
LF-102071.STEP
7.90 x 14.5 x 8.10 mm
