IMMRMKW/KICAD/Pin Header Socket 1x24 Pitch 2_54mm.STEP

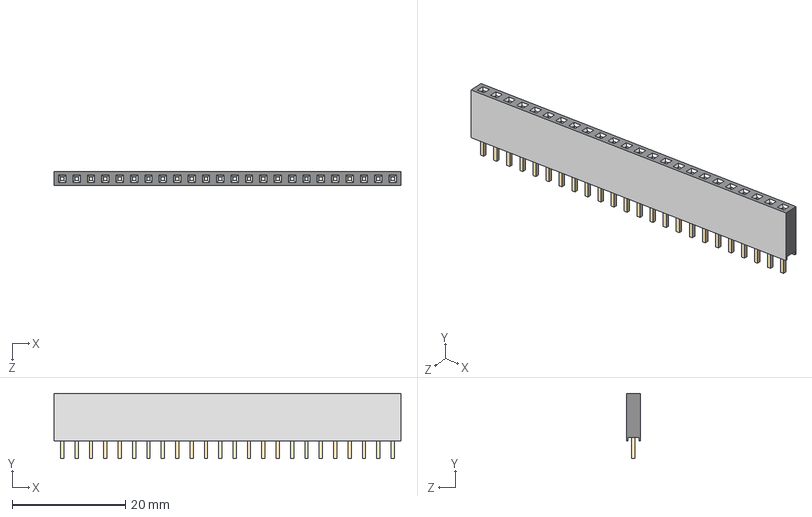
[picture p78: CAD file, 2021-05-26]
Pin Header Socket 1x24 Pitch 2_54mm.STEP
61.4 x 11.5 x 2.50 mm
