IMMRMKW/KICAD/b3fs-1000.stp

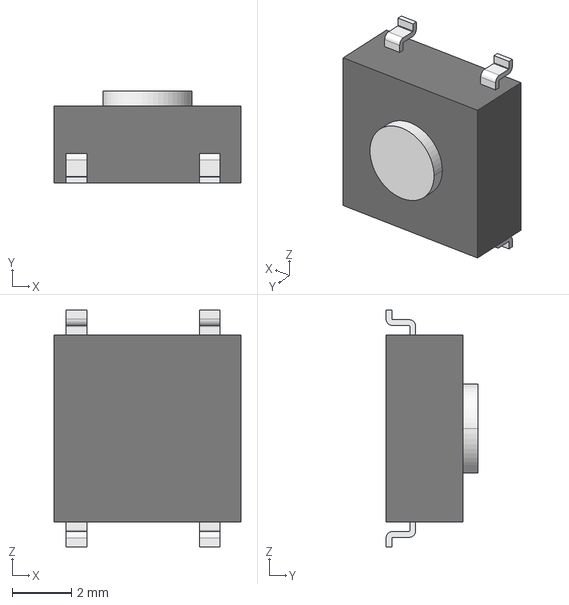
[picture p79: CAD file, 2021-05-26]
b3fs-1000.stp
6.30 x 3.10 x 8.00 mm
