IMMRMKW/KICAD/MS5525DSO.STEP

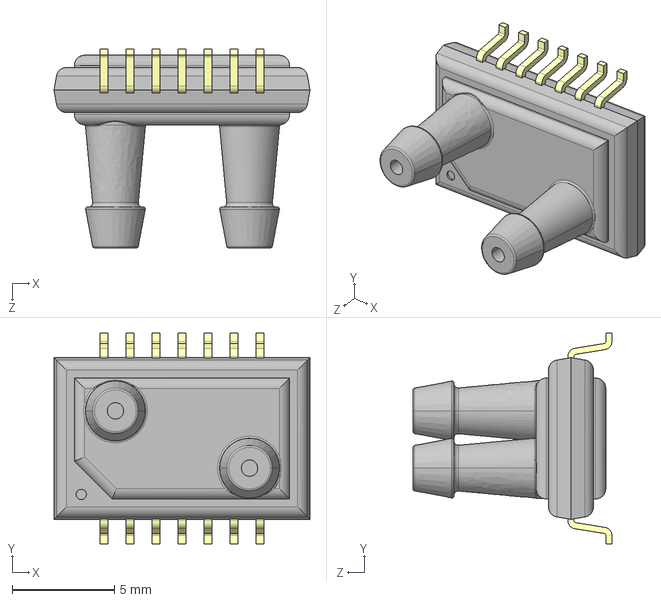
[picture p80: CAD file, 2021-05-26]
MS5525DSO.STEP
12.5 x 10.3 x 9.71 mm
MAIN BODY
PINS
