IMMRMKW/KICAD/SOIC8.STEP

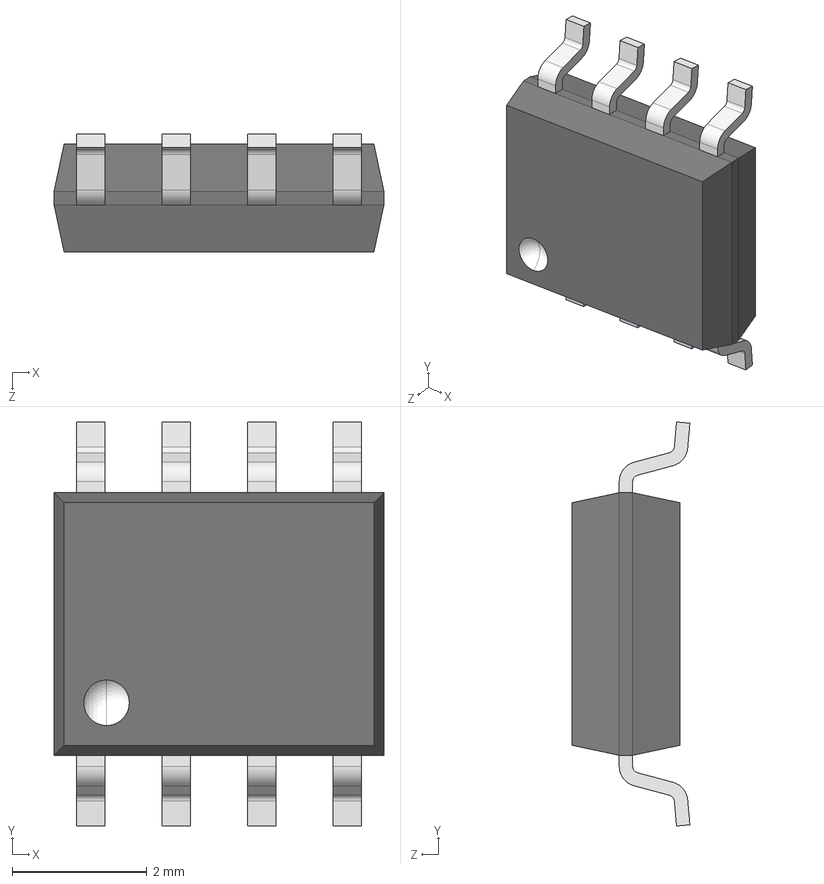
[picture p81: CAD file, 2021-05-26]
SOIC8.STEP
4.90 x 6.00 x 1.75 mm
