IMMRMKW/KICAD/31_75x6_35mm_fuse.STEP

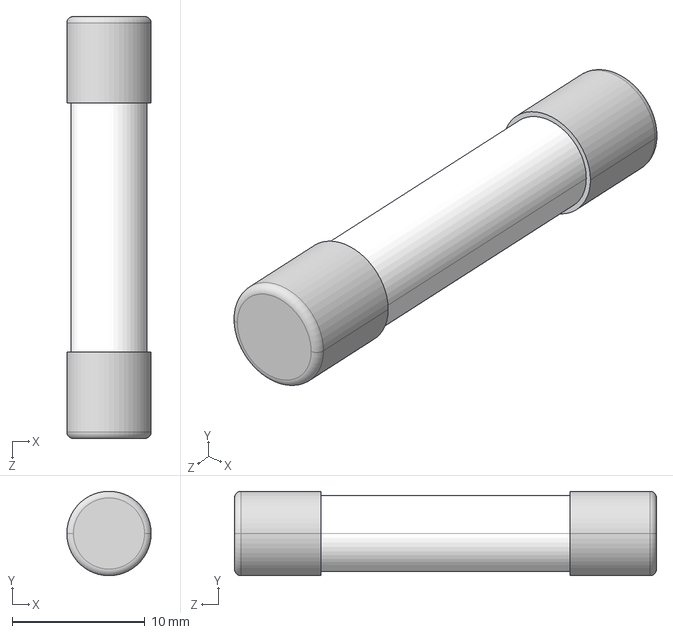
[picture p82: CAD file, 2021-05-26]
31_75x6_35mm_fuse.STEP
6.35 x 6.35 x 31.8 mm
