IMMRMKW/KICAD/Keystone-PN3557-2.STEP

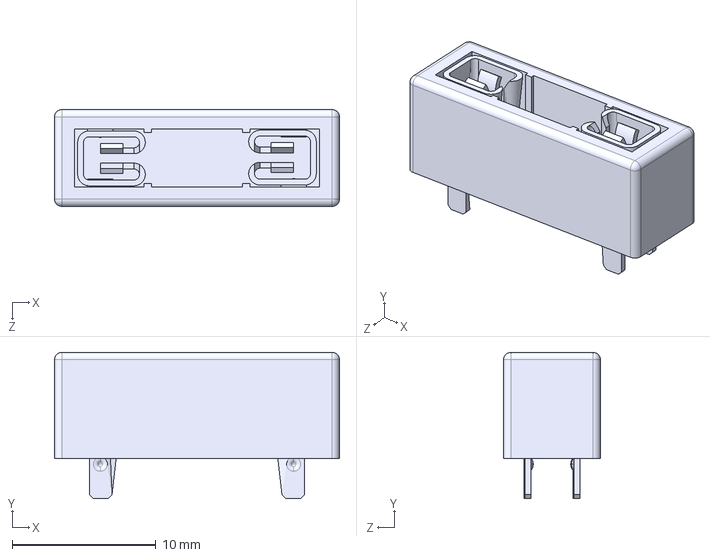
[picture p83: CAD file, 2021-05-26]
Keystone-PN3557-2.STEP
19.8 x 10.2 x 6.73 mm
