IMMRMKW/KICAD/TDPT 2,5 2-sp-5,08.stp

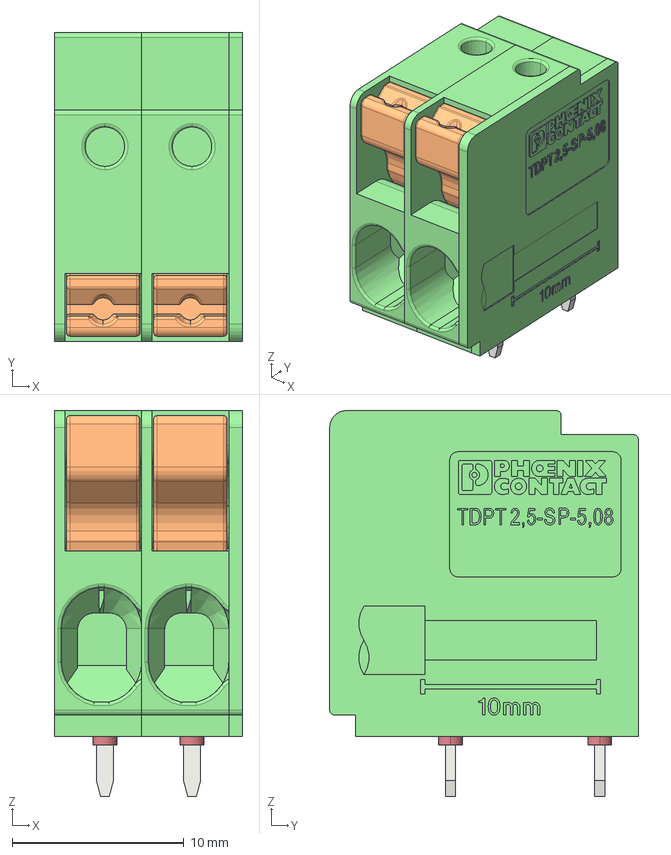
[picture p84: CAD file, 2021-05-26]
TDPT 2,5 2-sp-5,08.stp
11.0 x 18.0 x 22.5 mm
