IMMRMKW/KICAD/c-2314844-6-5-3d.stp

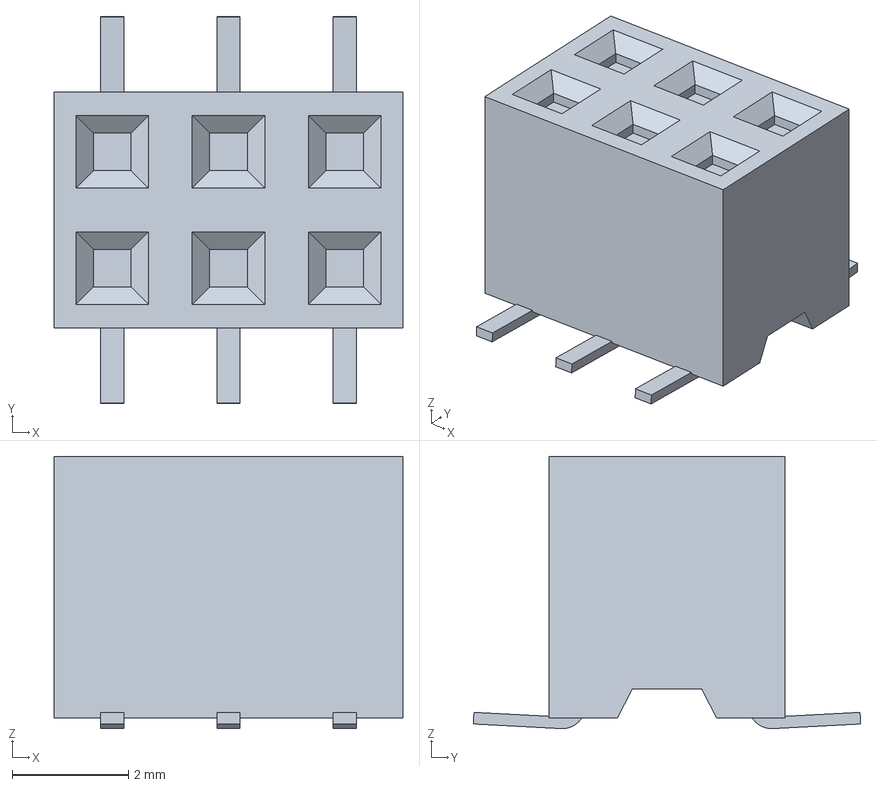
[picture p85: CAD file, 2021-05-26]
c-2314844-6-5-3d.stp
6.00 x 6.66 x 4.68 mm
