IMMRMKW/KICAD/VTB8440.STEP

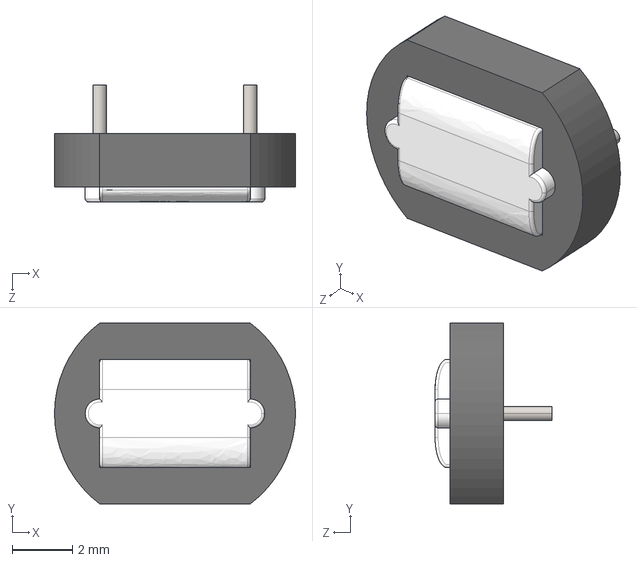
[picture p86: CAD file, 2021-03-19]
VTB8440.STEP
8.00 x 6.00 x 3.88 mm
