IMMRMKW/KICAD/ASPIAIG-S4035.STEP

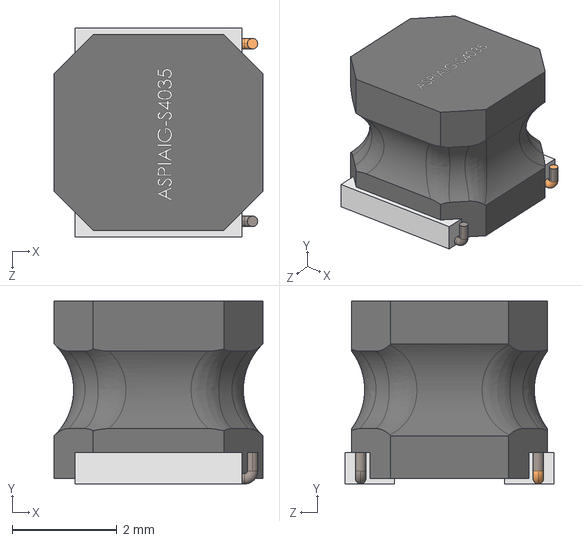
[picture p87: CAD file, 2019-10-24]
ASPIAIG-S4035.STEP
4.00 x 3.50 x 4.00 mm
