IMMRMKW/KICAD/JST - XH - Thru - 2Pin - 2.5mm (Genuine).stp

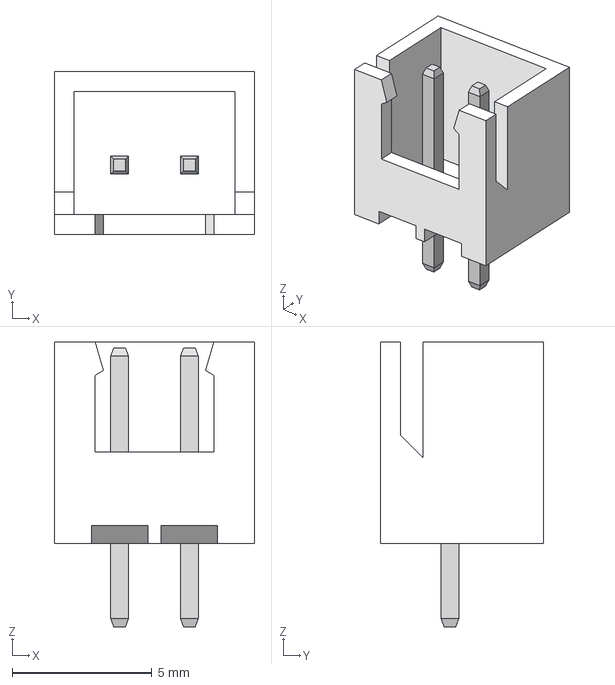
[picture p88: CAD file, 2019-10-24]
JST - XH - Thru - 2Pin - 2.5mm (Genuine).stp
7.17 x 5.84 x 10.2 mm
