IMMRMKW/KICAD/JST - XH - Thru - 3Pin - 2.5mm (Genuine).stp

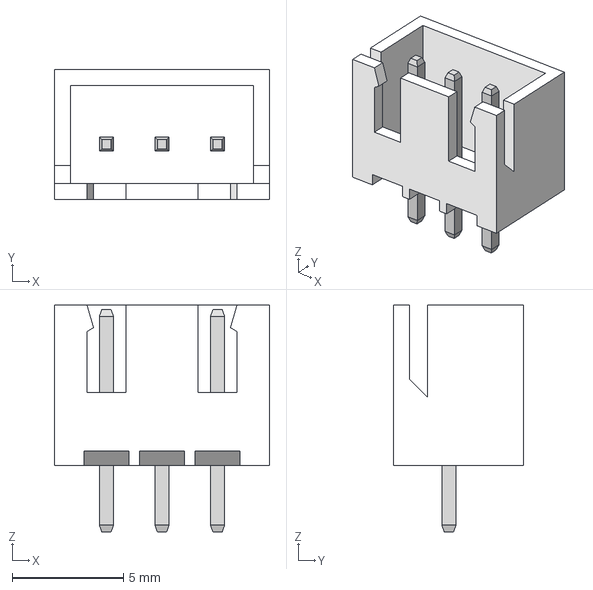
[picture p89: CAD file, 2019-10-24]
JST - XH - Thru - 3Pin - 2.5mm (Genuine).stp
9.67 x 5.84 x 10.2 mm
