IMMRMKW/KICAD/KSR252GLFS.STEP

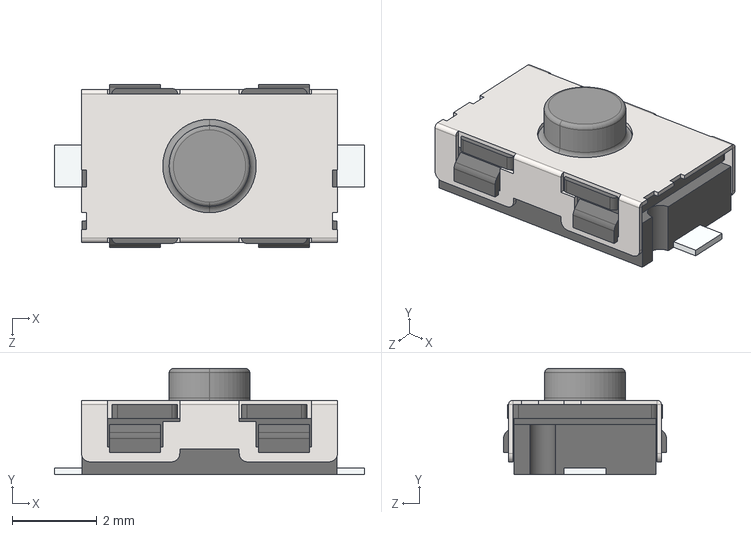
[picture p90: CAD file, 2019-10-24]
KSR252GLFS.STEP
7.30 x 2.50 x 3.84 mm
