IMMRMKW/KICAD/VQFN-10.STEP

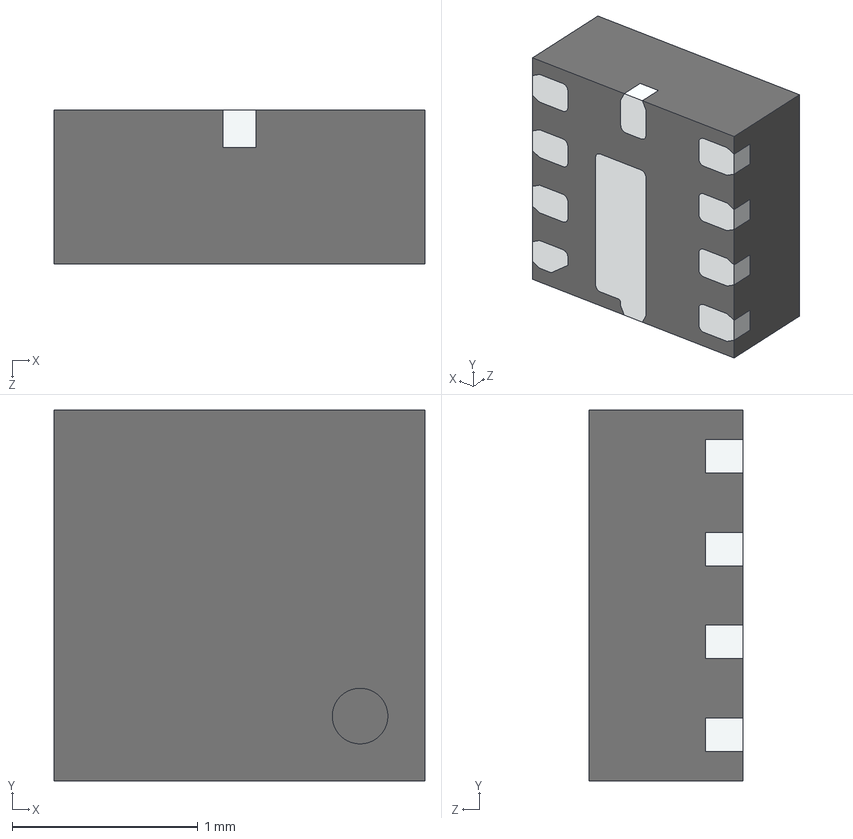
[picture p91: CAD file, 2019-10-13]
VQFN-10.STEP
2.00 x 2.00 x 0.83 mm
