IMMRMKW/KICAD/DO-214AA.STEP

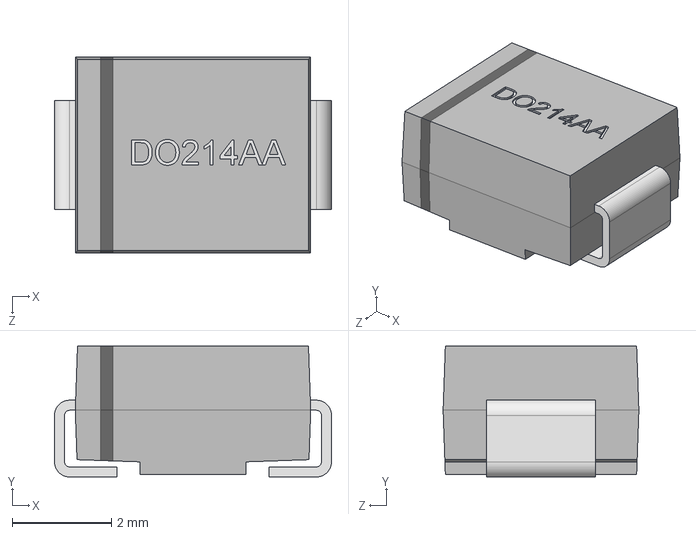
[picture p92: CAD file, 2019-10-13]
DO-214AA.STEP
5.59 x 2.64 x 3.95 mm
