IMMRMKW/KICAD/Radial can size F.STEP

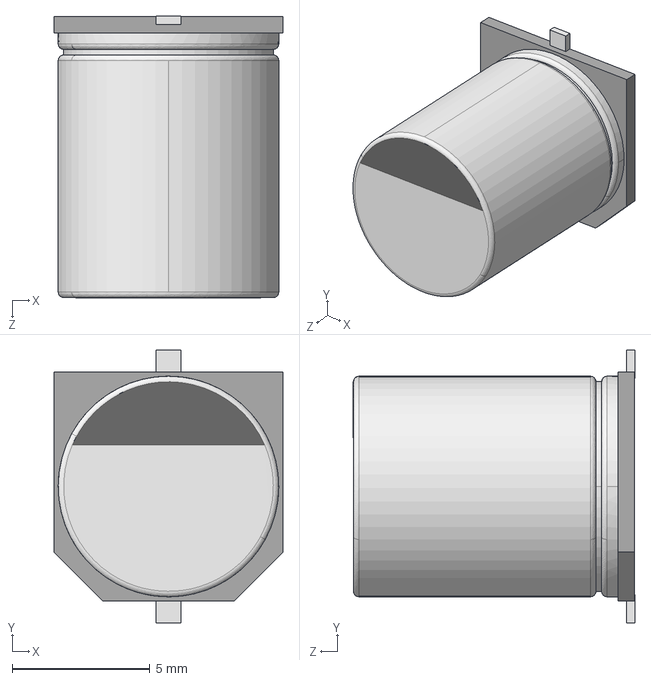
[picture p93: CAD file, 2019-10-13]
Radial can size F.STEP
8.30 x 9.90 x 10.2 mm
