IMMRMKW/KICAD/SOT-723.STEP

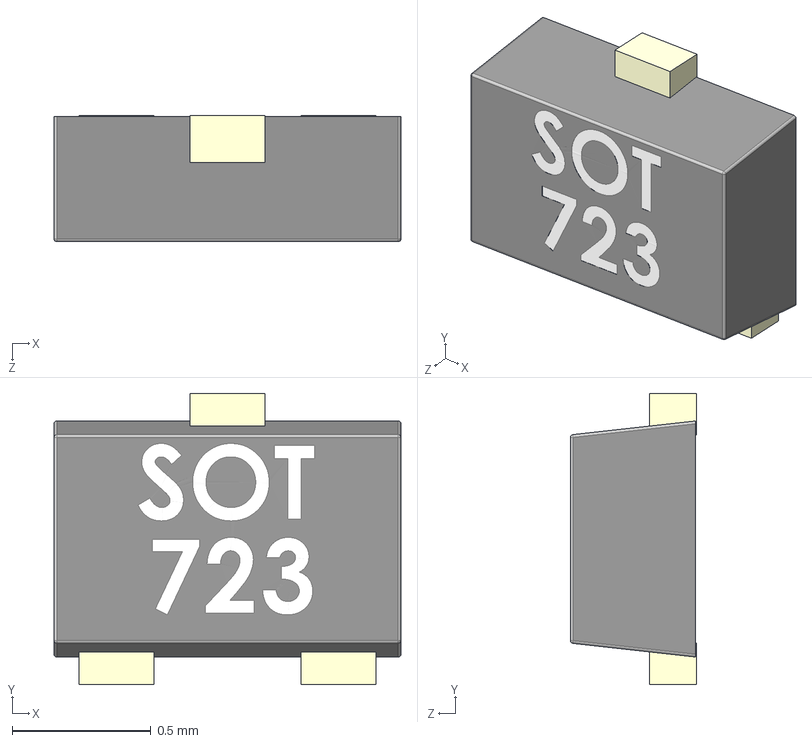
[picture p94: CAD file, 2019-10-13]
SOT-723.STEP
1.25 x 1.05 x 0.455 mm
