IMMRMKW/KICAD/0ZCG-0_70mm.STEP

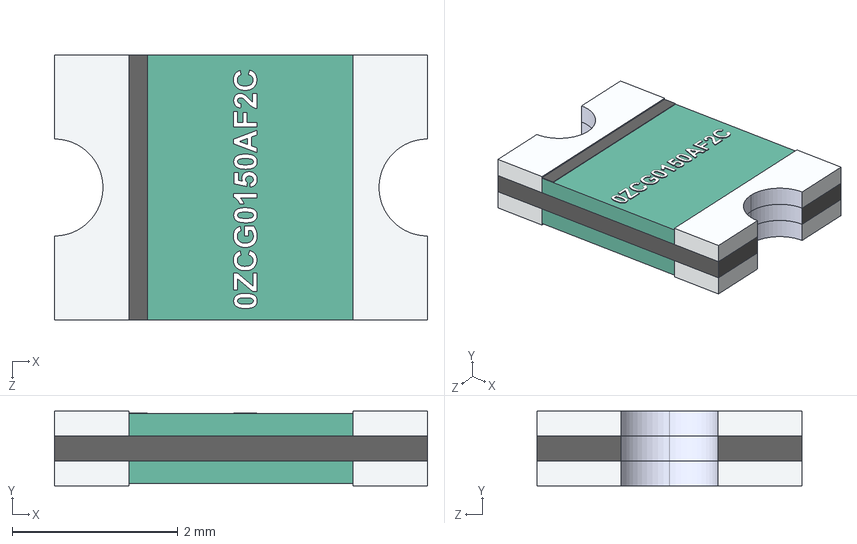
[picture p95: CAD file, 2019-10-13]
0ZCG-0_70mm.STEP
4.50 x 0.9 x 3.20 mm
