IMMRMKW/KICAD/MEM2075-00-140-01-A.stp

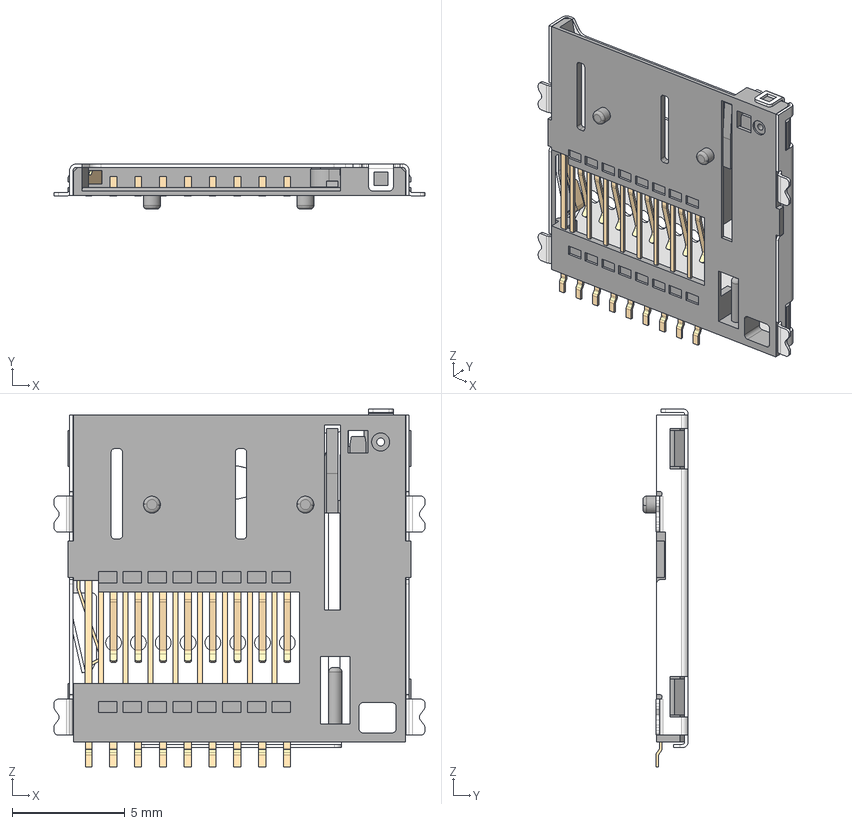
[picture p96: CAD file, 2019-10-13]
MEM2075-00-140-01-A.stp
16.4 x 2.00 x 15.9 mm
Ëõ·Å±ÈÀý1
Í¹Ì¨-ÀÉì1
Á¬½ÓÖØ×é1
