IMMRMKW/KICAD/JST - XH - SMD (R) - 3Pin - 2.54mm.stp

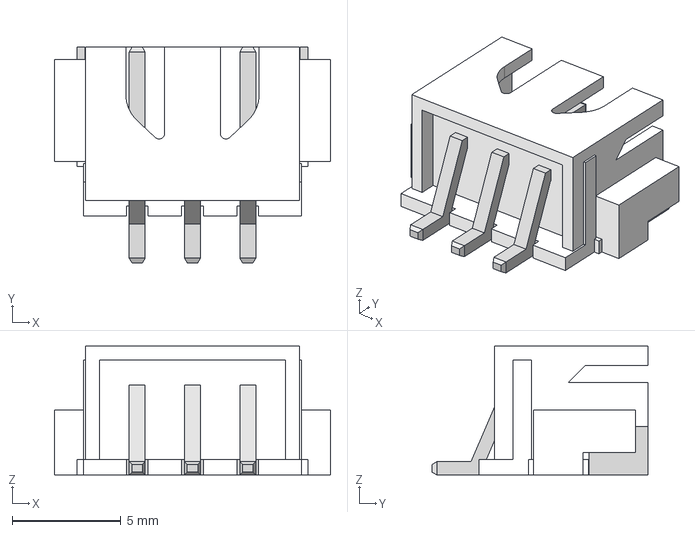
[picture p97: CAD file, 2019-10-13]
JST - XH - SMD (R) - 3Pin - 2.54mm.stp
12.7 x 9.91 x 5.92 mm
