IMMRMKW/KICAD/JST - XH - SMD (R) - 2Pin - 2.54mm.stp

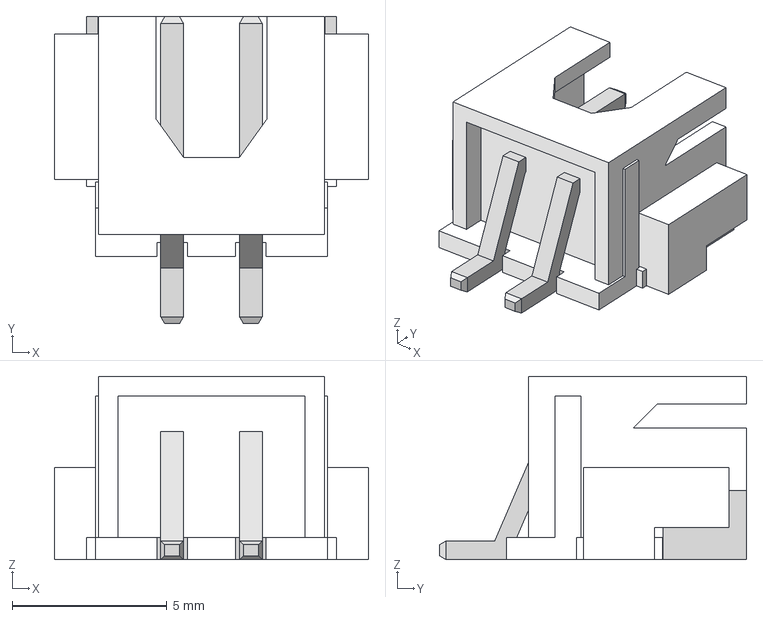
[picture p98: CAD file, 2019-10-13]
JST - XH - SMD (R) - 2Pin - 2.54mm.stp
10.1 x 9.91 x 5.92 mm
