IMMRMKW/KICAD/PAT9125Package.STEP

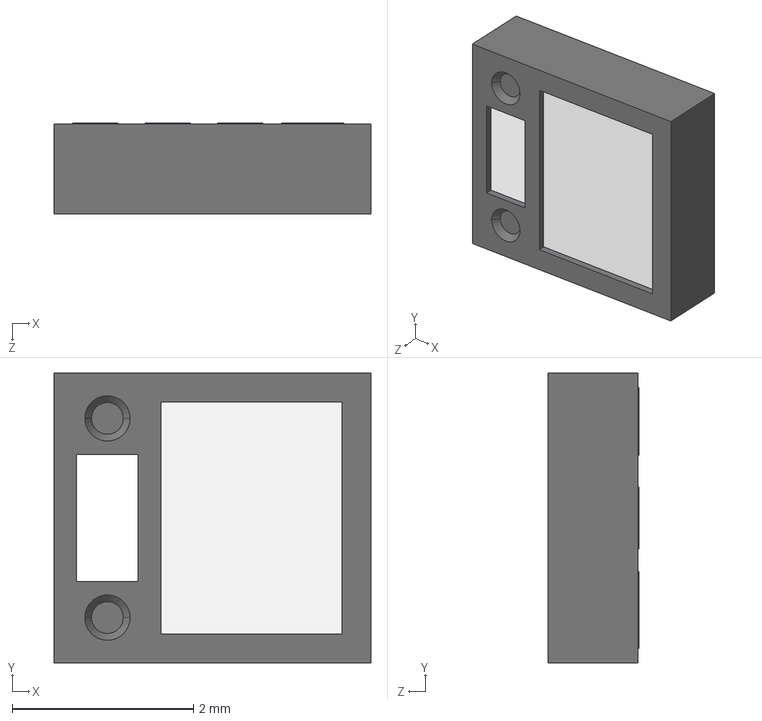
[picture p99: CAD file, 2019-05-24]
PAT9125Package.STEP
3.50 x 3.20 x 1.00 mm
