IMMRMKW/KICAD/BM02B-GHS-TBT.STEP

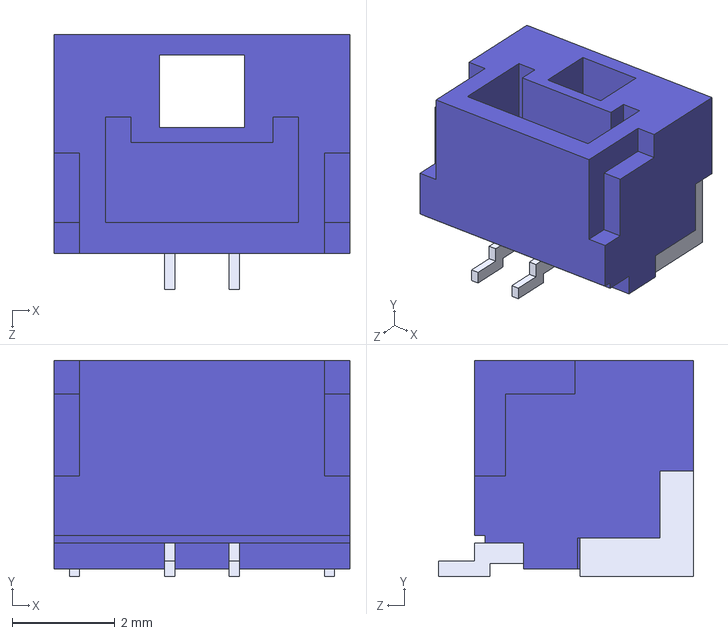
[picture p100: CAD file, 2019-04-13]
BM02B-GHS-TBT.STEP
5.75 x 4.20 x 4.95 mm
