IMMRMKW/KICAD/ALU-D.STEP

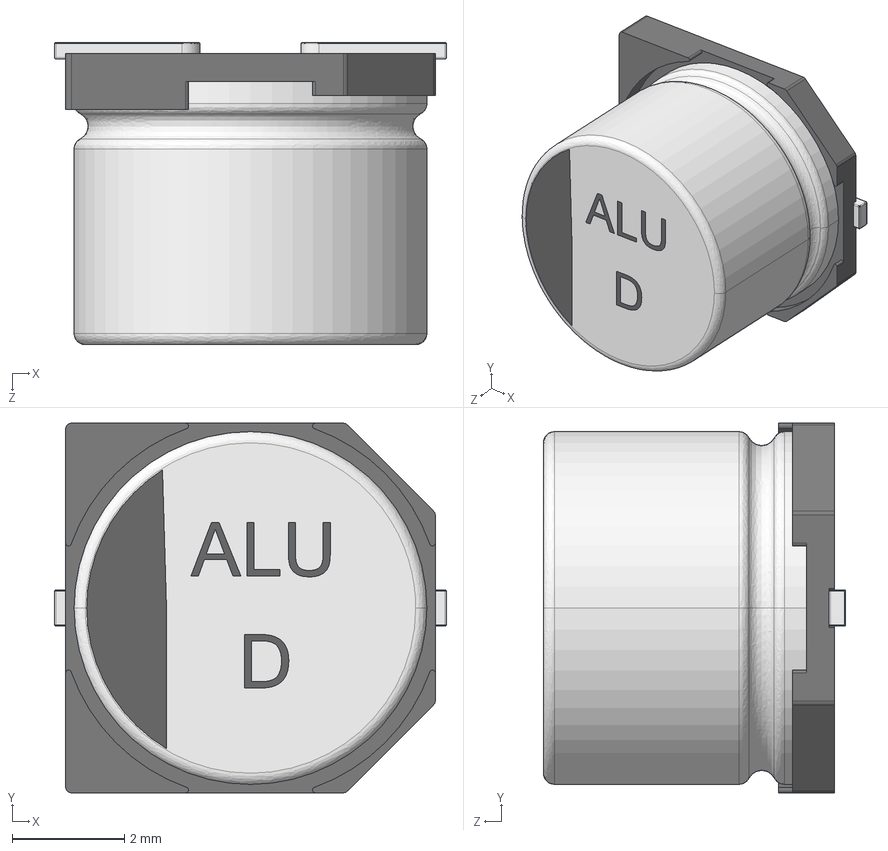
[picture p101: CAD file, 2019-04-04]
ALU-D.STEP
7.00 x 6.60 x 5.40 mm
User Library-ALU-D_Fuss_1
User Library-ALU-D_Pins_1
User Library-ALU-D_K_X_F6rper_1
User Library-ALU-D_Beschriftung_1
