IMMRMKW/KICAD/srr1260-100m.stp

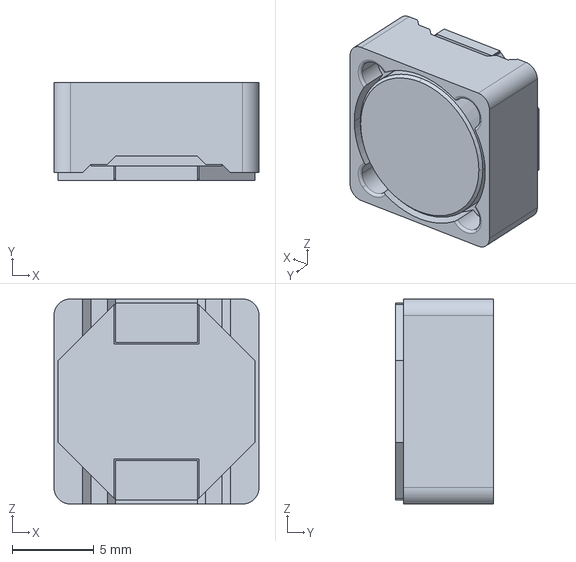
[picture p102: CAD file, 2019-04-04]
srr1260-100m.stp
12.5 x 6.00 x 12.5 mm
