IMMRMKW/KICAD/SM02B-GHS-TB.stp

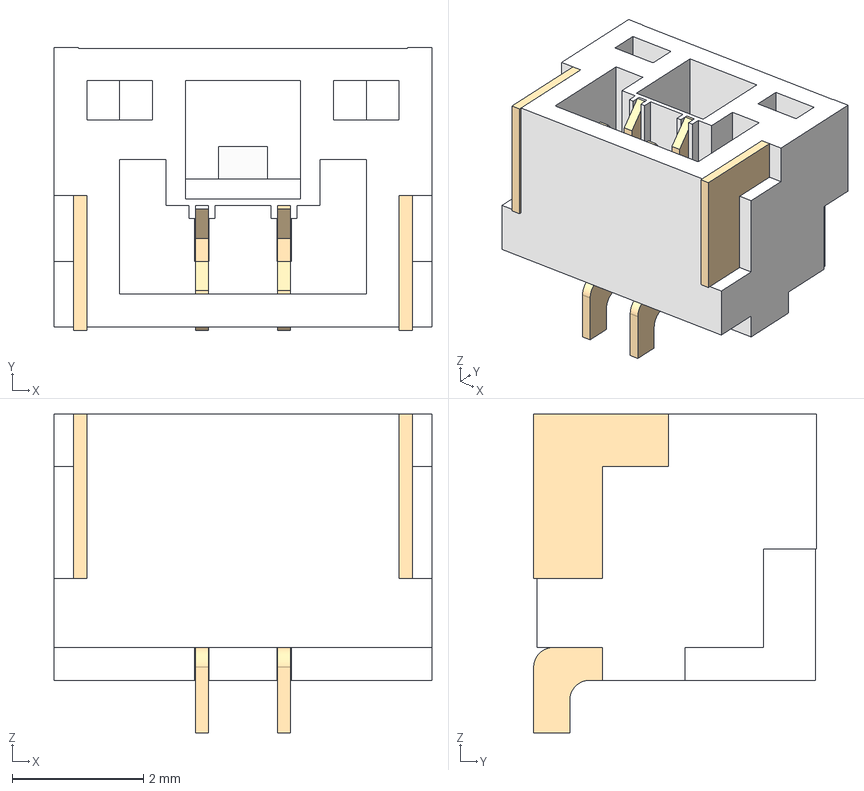
[picture p103: CAD file, 2019-03-31]
SM02B-GHS-TB.stp
5.75 x 4.30 x 4.85 mm
