IMMRMKW/KICAD/SM04B-GHS-TB.stp

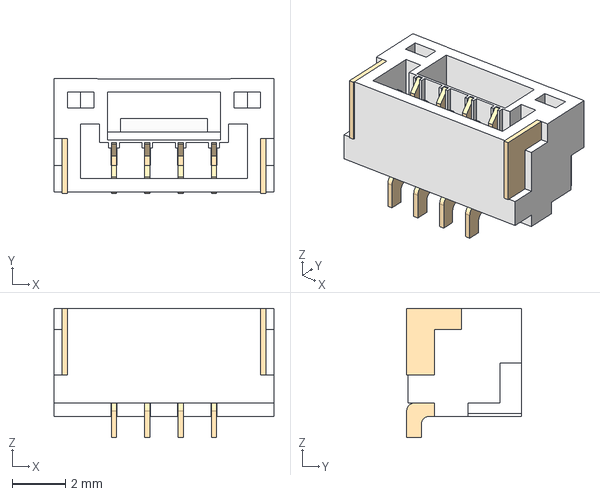
[picture p104: CAD file, 2019-03-31]
SM04B-GHS-TB.stp
8.25 x 4.30 x 4.85 mm
