IMMRMKW/KICAD/SM03B-GHS-TB.stp

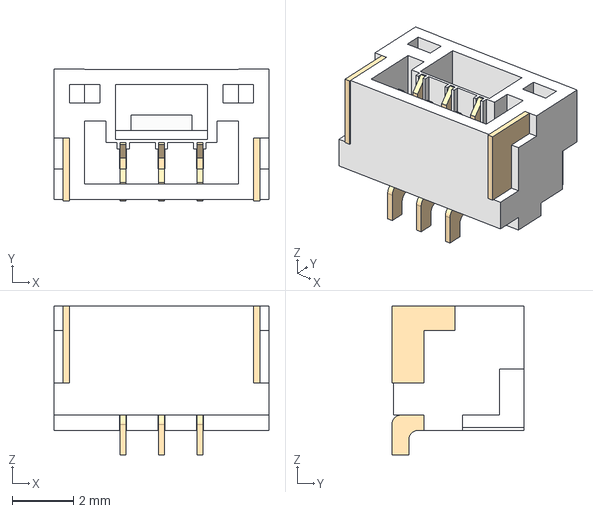
[picture p105: CAD file, 2019-03-31]
SM03B-GHS-TB.stp
7.00 x 4.30 x 4.85 mm
