IMMRMKW/KICAD/KiCAD-ESP-WROOM-32.step

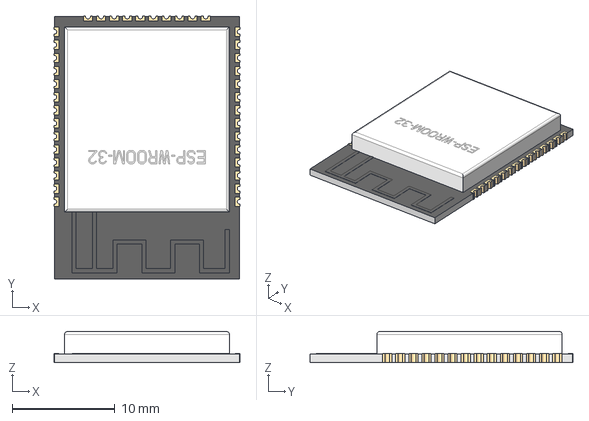
[picture p106: CAD file, 2019-03-31]
KiCAD-ESP-WROOM-32.step
18.1 x 25.5 x 3.04 mm
