IMMRMKW/KICAD/PanasonicRadialCanSizeE.STEP

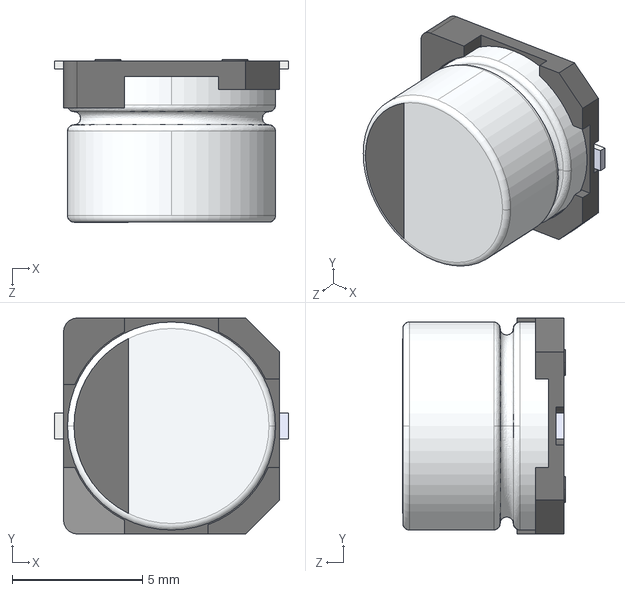
[picture p107: CAD file, 2019-03-31]
PanasonicRadialCanSizeE.STEP
9.00 x 8.30 x 6.25 mm
