IMMRMKW/KICAD/WurthMicroSDHolder-693072010801.stp

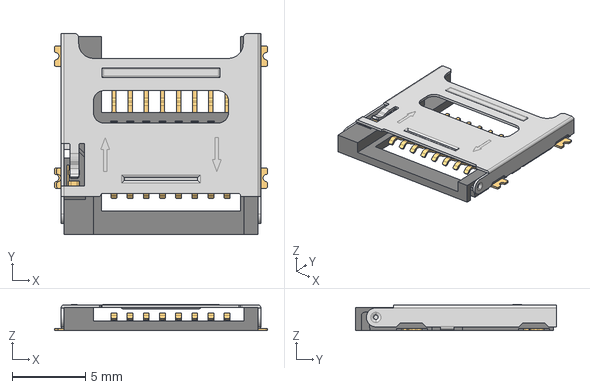
[picture p108: CAD file, 2019-03-31]
WurthMicroSDHolder-693072010801.stp
14.5 x 13.7 x 1.77 mm
