IMMRMKW/KICAD/keystone-PN1047.STEP

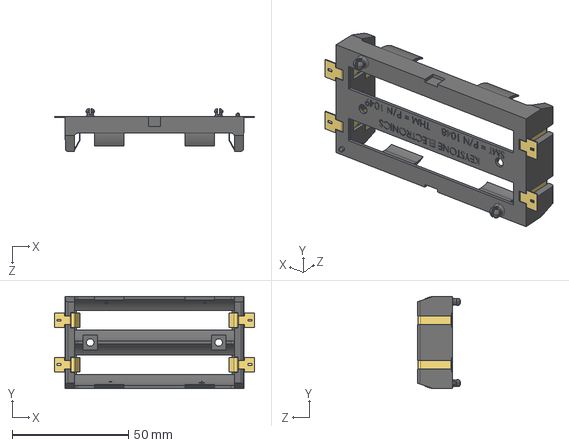
[picture p109: CAD file, 2019-03-31]
keystone-PN1047.STEP
86.0 x 39.8 x 18.3 mm
