IMMRMKW/KICAD/keystone-PN1047-Aliexpress.STEP

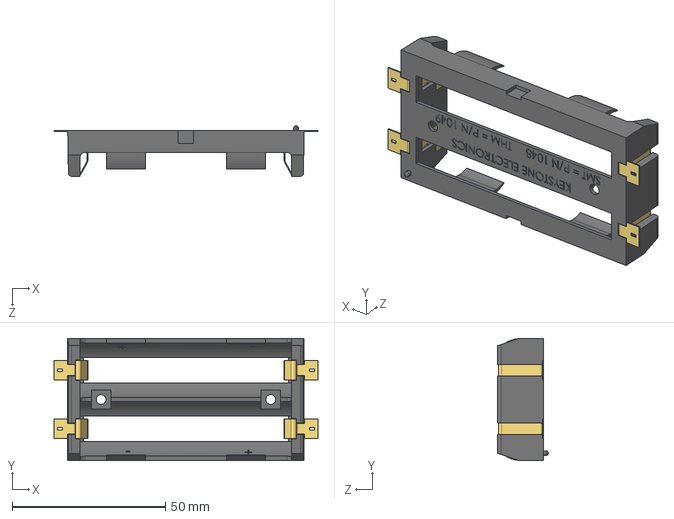
[picture p110: CAD file, 2019-03-31]
keystone-PN1047-Aliexpress.STEP
86.0 x 39.8 x 16.5 mm
