IMMRMKW/KICAD/OAR3.STEP

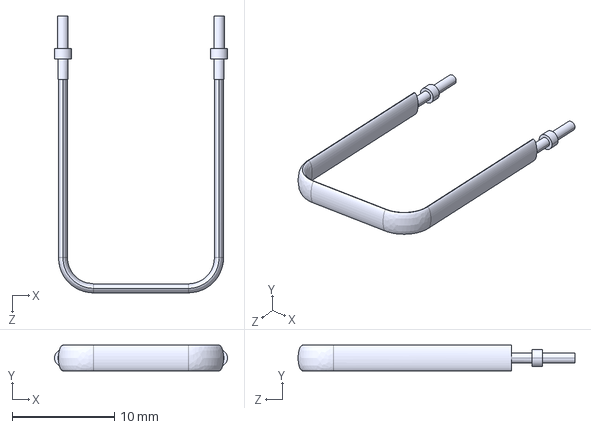
[picture p111: CAD file, 2019-01-28]
OAR3.STEP
16.9 x 2.50 x 27.0 mm
