IMMRMKW/KICAD/Harwin S2761-46R.STEP

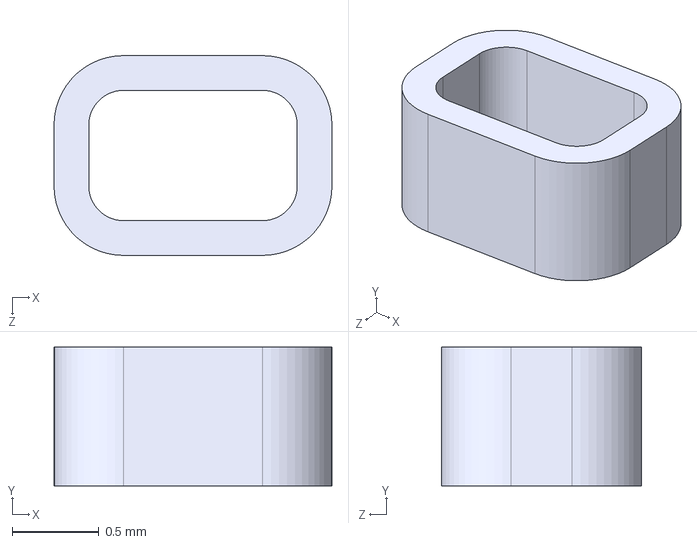
[picture p112: CAD file, 2019-01-28]
Harwin S2761-46R.STEP
1.60 x 0.8 x 1.15 mm
