IMMRMKW/KICAD/COIL.STEP

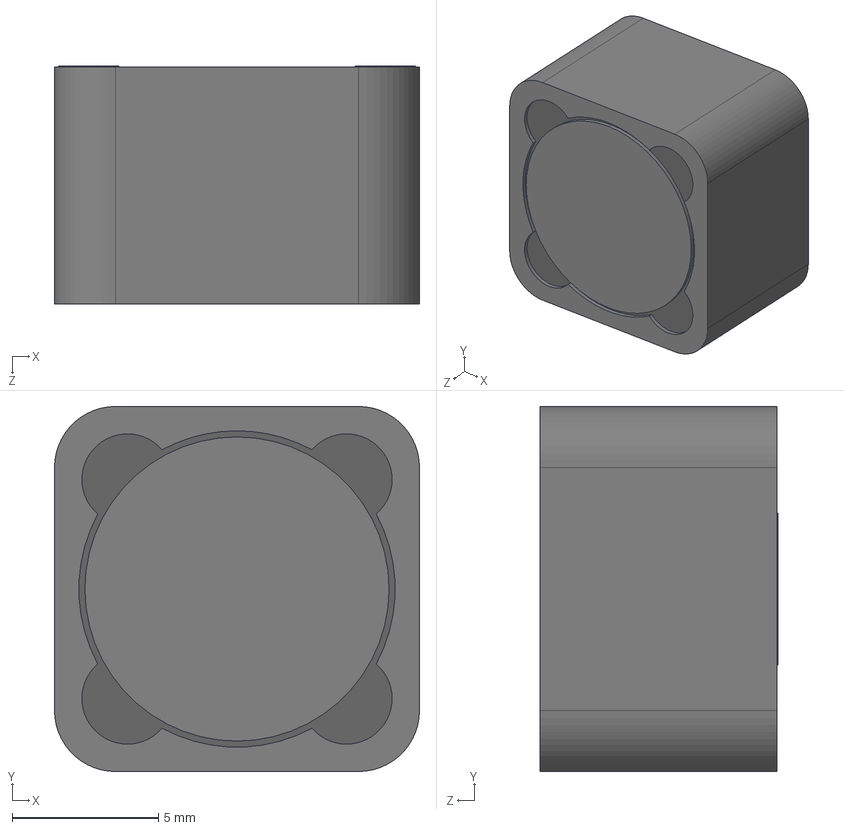
[picture p113: CAD file, 2019-01-28]
COIL.STEP
12.5 x 12.5 x 8.17 mm
