IMMRMKW/KICAD/HDMI_socket.STEP

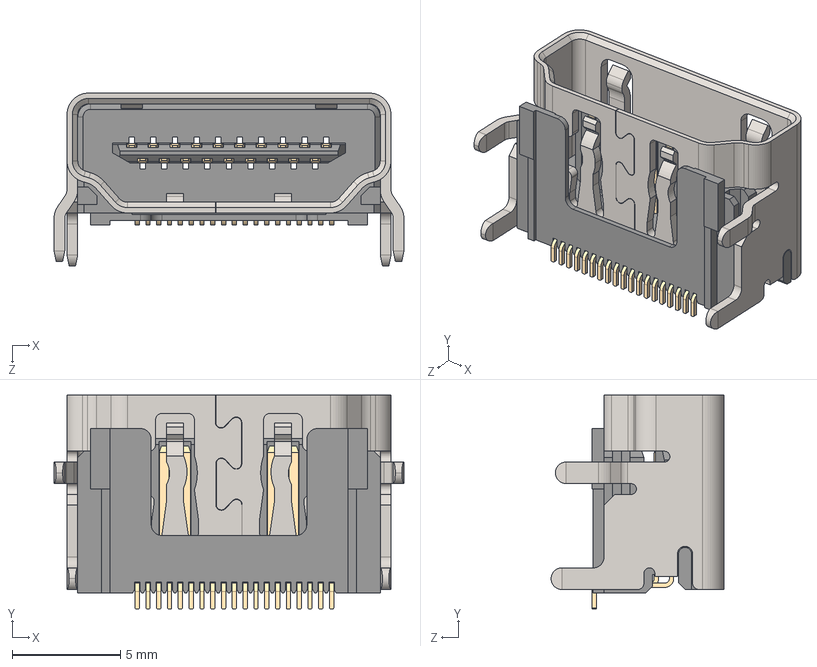
[picture p114: CAD file, 2018-11-29]
HDMI_socket.STEP
16.2 x 9.90 x 8.00 mm
HDMI_socket_cover.STEP
HDMI_socket_inside.STEP
HDMI_socket_large_pin.STEP x 10
HDMI_socket_small_pin.STEP x 9
