IMMRMKW/KICAD/HSOIC.STEP

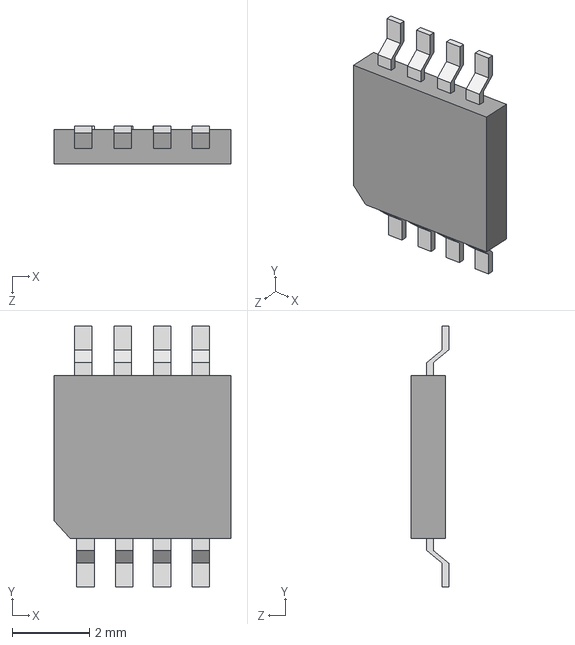
[picture p115: CAD file, 2018-11-29]
HSOIC.STEP
4.58 x 6.77 x 0.974 mm
