IMMRMKW/KICAD/HSOIC08.STEP

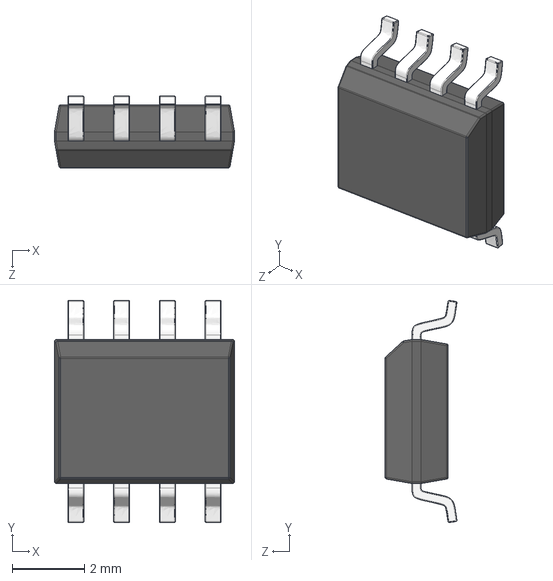
[picture p116: CAD file, 2018-11-29]
HSOIC08.STEP
5.00 x 6.16 x 2.00 mm
