IMMRMKW/KICAD/(list of files, cad)

Other CAD files:
HDMI_socket2.STEP
026604040.STEP
026604060.STEP
1050170001.stp
1051330001.stp
1718130002.STEP
470531000.stp
614105150721.stp
7499010121A (rev1).stp
Harwin S2761-46R.SLDPRT
KSR252GLFS.SLDPRT
KSR252GLFS.stp
Keystone-PN3557-2.SLDPRT
Multicomp-ABI-050-RC.SLDPRT
OAR3.SLDPRT
PCL712A.SLDPRT
Pin Header Socket 1x24 Pitch 2_54mm.SLDPRT
Pin Header Socket 1x5 Pitch 2_54mm.SLDPRT
SMMS0850.SLDPRT
VQFN-10.SLDPRT
VTB8440.SLDPRT
Yuandi TS-1092S-B3D2-G.SLDPRT
