IMMRMKW/KICAD/(commit log)

2018-11-29 Changed ESP32 footprint, added 3D shapes
    [026604040.STEP, 026604060.STEP, 1718130002.STEP, HDMI_socket.STEP, HDMI_socket2.STEP, HSOIC.STEP, HSOIC08.STEP, molex_0471510001.STEP]
2019-01-28 Added microSDSocket
    [COIL.STEP, Harwin S2761-46R.SLDPRT, Harwin S2761-46R.STEP, OART3.SLDPRT, OART3.STEP]
2019-03-22 changed sd card holder. Slight error in placement of alignment holes
2019-03-31 Added 3D shapes to battery holders
    [keystone-PN1047-Aliexpress.STEP, keystone-PN1047.STEP]
2019-03-31 Added 3D shapes of panasonic radial can size E and wurth sd card holder
    [1051330001.stp, KiCAD-ESP-WROOM-32.step, PanasonicRadialCanSizeE.STEP, SM02B-GHS-TB.stp, SM03B-GHS-TB.stp, SM04B-GHS-TB.stp, WurthMicroSDHolder-693072010801.stp]
2019-04-04 Added 3D shapes of some component, like the srr1260
    [ALU-D.STEP, srr1260-100m.stp]
2019-04-13 Renamed some parts
    [BM02B-GHS-TBT.STEP, OAR3.SLDPRT, OAR3.STEP]
2019-05-02 HDMI connector was mirrored, corrected this
2019-05-24 Added 3D model of pat9125
    [PAT9125Package.STEP]
2019-10-13 added more parts, made small changes
    [0ZCG-0_70mm.STEP, 1050170001.stp, 614105150721.stp, DO-214AA.STEP, JST - XH - SMD (R) - 2Pin - 2.54mm.stp, JST - XH - SMD (R) - 3Pin - 2.54mm.stp, MEM2075-00-140-01-A.stp, Radial can size F.STEP]
2019-10-24 Added more components and step files
    [ASPIAIG-S4035.STEP, JST - XH - Thru - 2Pin - 2.5mm (Genuine).stp, JST - XH - Thru - 3Pin - 2.5mm (Genuine).stp, KSR252GLFS.SLDPRT, KSR252GLFS.STEP, KSR252GLFS.stp]
2021-03-19 added some more libraries
    [VTB8440.SLDPRT, VTB8440.STEP]
2021-05-26 more models
    [2061-602_998-404.stp, 31_75x6_35mm_fuse.STEP, 7499010121A (rev1).stp, Automotive_fuse.STEP, Keystone-PN3557-2.STEP, LF-102071.STEP, MS5525DSO.STEP, Pin Header Socket 1x24 Pitch 2_54mm.SLDPRT]
2021-09-19 library update
    [031-5539.STEP, Keystone-PN3557-2.SLDPRT, Multicomp-ABI-050-RC.SLDPRT, Multicomp-ABI-050-RC.STEP, PCL712A.SLDPRT, PCL712A.step, nc3fbv2-1.stp]
2023-07-05 added multiple components
    [470531000.stp, BM02B-SRSS-TB.STEP, BM03B-SRSS-TB.STEP, BM04B-SRSS-TB.STEP, BM05B-SRSS-TB.STEP, BM06B-SRSS-TB.STEP, BM07B-SRSS-TB.STEP, BM08B-SRSS-TB.STEP]
2023-08-11 removed bug in kelvin-connected capacitor
2026-10-10 some new symbols and footprints
