IMMRMKW/KICAD/(notices)

Notices in the files:
2061-602_998-404.stp:
FILE_NAME( 'p:/temp/worker_74/temp/exporttempdir_2420_922_4FBt6/format_0/2061-602_998-404.stp', '2021-05-19T08:01:10', ( 'License CC BY-ND 4.0' ), ( 'CADENAS' ), ' ', 'PARTsolutions', ' ' );
